chris83527/anna_elsa_schematics/anna_elsa_esp32_cpu/anna_elsa_esp32_cpu.png

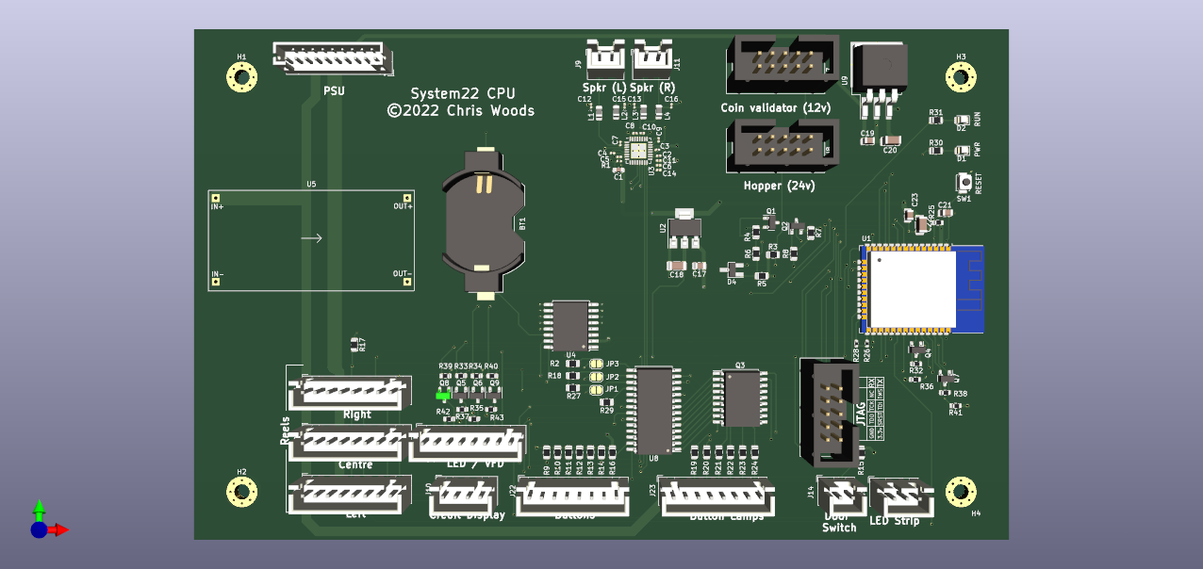
anna_elsa_esp32_cpu/anna_elsa_esp32_cpu.png
