chris83527/anna_elsa_schematics/README.md

# Schematics for Anna & Elsa fruit machine project
## based on ESP32 microcontroller
