chris83527/anna_elsa_schematics/anna_elsa_esp32_cpu/gerbers/board/anna_elsa_esp32_cpu-B_Cu.dxf

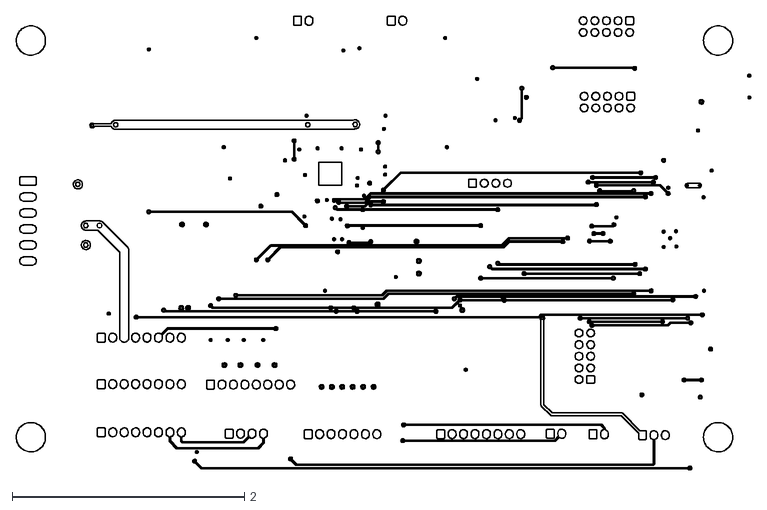
[picture p2: CAD file, 2023-01-22]
anna_elsa_esp32_cpu/gerbers/board/anna_elsa_esp32_cpu-B_Cu.dxf
6.32 x 3.90
