chris83527/anna_elsa_schematics/anna_elsa_esp32_cpu/gerbers/board/anna_elsa_esp32_cpu-F_Cu.dxf

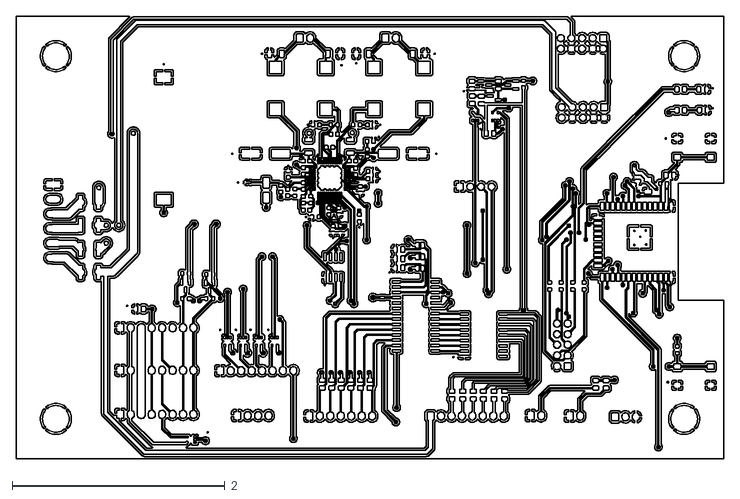
[picture p4: CAD file, 2023-01-22]
anna_elsa_esp32_cpu/gerbers/board/anna_elsa_esp32_cpu-F_Cu.dxf
6.66 x 4.16
