chris83527/anna_elsa_schematics/anna_elsa_esp32_cpu/gerbers/board/anna_elsa_esp32_cpu-Edge_Cuts.dxf

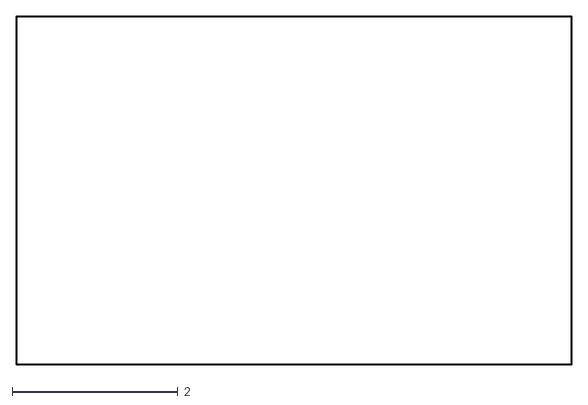
[picture p5: CAD file, 2023-01-22]
anna_elsa_esp32_cpu/gerbers/board/anna_elsa_esp32_cpu-Edge_Cuts.dxf
6.70 x 4.20
