chris83527/anna_elsa_schematics/anna_elsa_esp32_cpu/gerbers/board/anna_elsa_esp32_cpu-In2_Cu.dxf

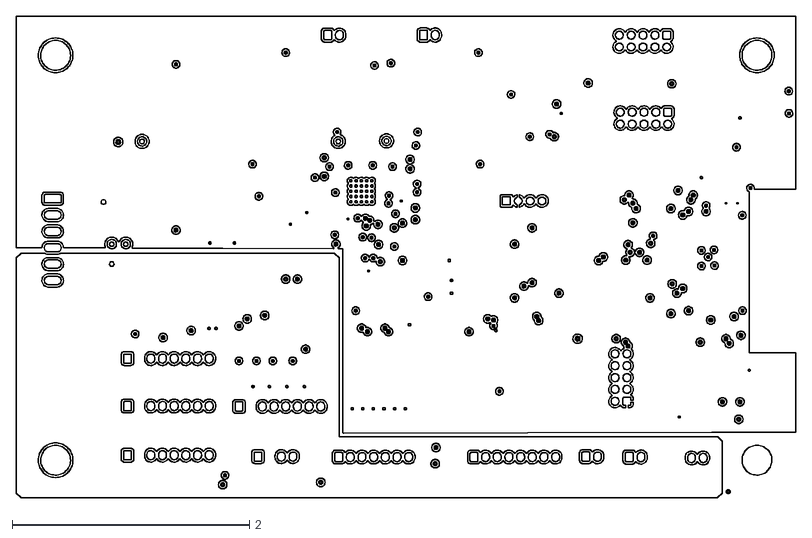
[picture p6: CAD file, 2023-01-22]
anna_elsa_esp32_cpu/gerbers/board/anna_elsa_esp32_cpu-In2_Cu.dxf
6.57 x 4.06
