chris83527/anna_elsa_schematics/(list of files, cad)

Other CAD files:
anna_elsa_esp32_cpu/gerbers/board/anna_elsa_esp32_cpu-F_Mask.dxf
anna_elsa_esp32_cpu/gerbers/board/anna_elsa_esp32_cpu-F_Paste.dxf
anna_elsa_esp32_cpu/gerbers/board/anna_elsa_esp32_cpu-F_Silkscreen.dxf
