chris83527/anna_elsa_schematics/anna_elsa_esp32_cpu/Board2Pdf/anna_elsa_esp32_cpu-Assembly.pdf

1 | 2 | 3 | 4 | 5 | 6

A

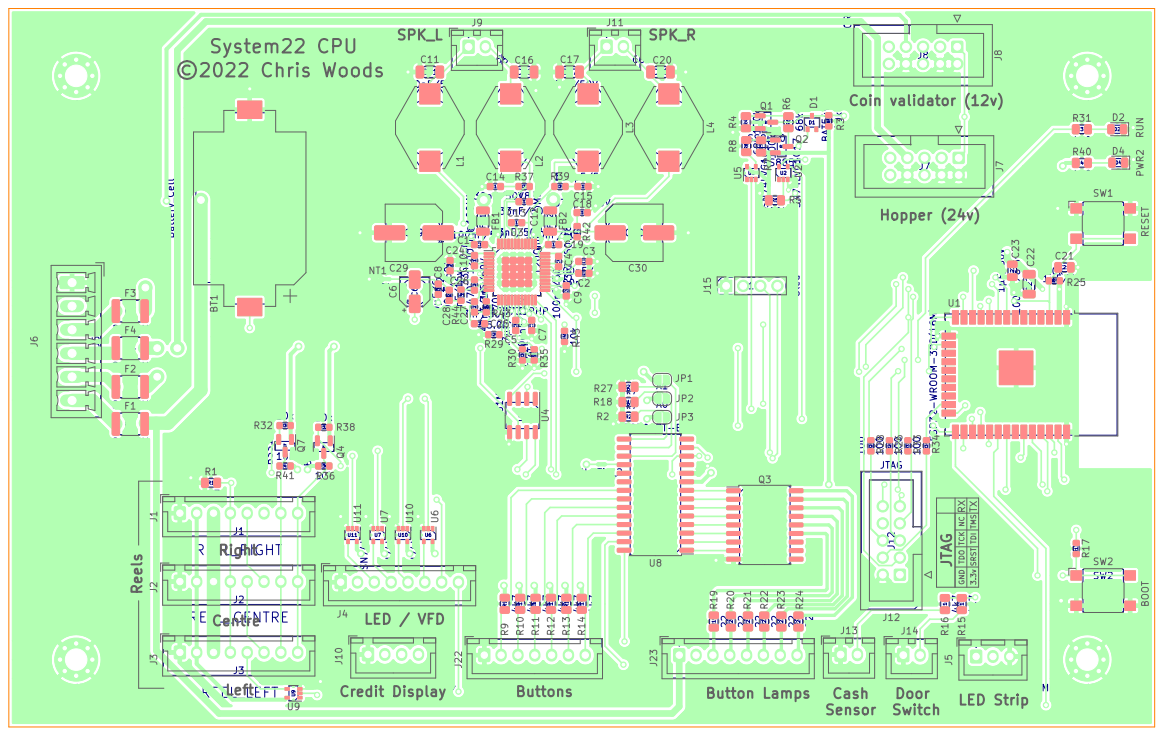
[picture p7: page 1]

Id: 1/1 Title: File: anna_elsa_esp32_cpu.kicad_pcb Sheet: ColoredTop

1 | 2 | 3 | 4 | 5 | 6

A

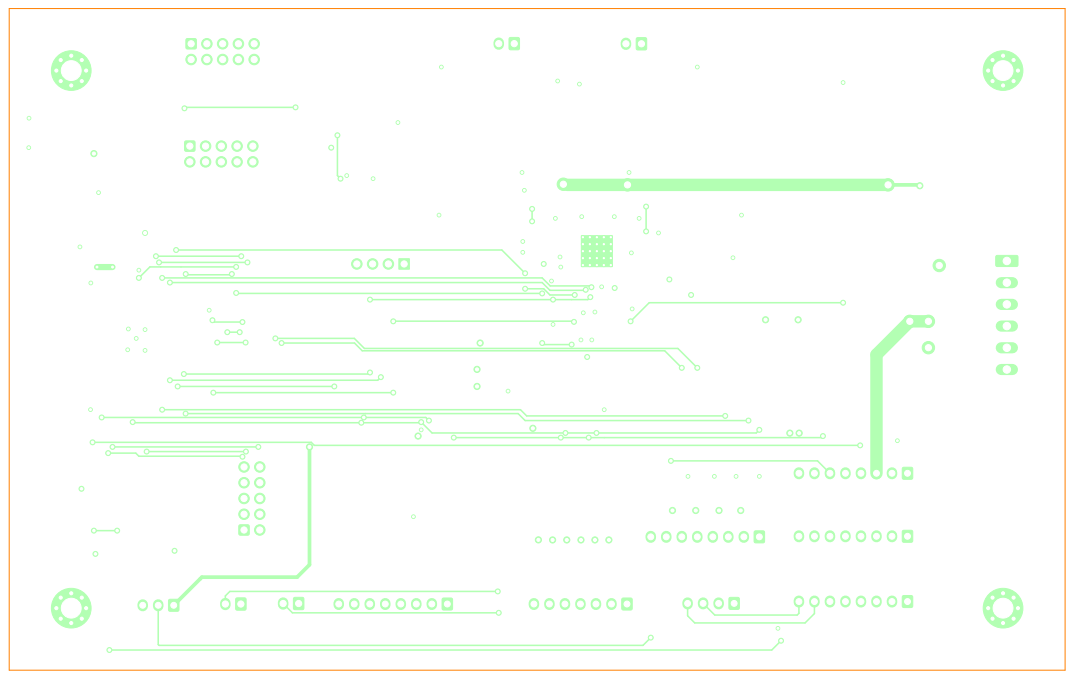
[picture p8: page 2]
D Date: KiCad; kicad; 6.0.11-2627ca5db0~126~ubuntu20.04.1 Size: A4; Rev:

Id: 1/1 Title: File: anna_elsa_esp32_cpu.kicad_pcb Sheet: ColoredBottom
