chris83527/anna_elsa_schematics/anna_elsa_esp32_cpu/anna_elsa_esp32_cpu.pdf

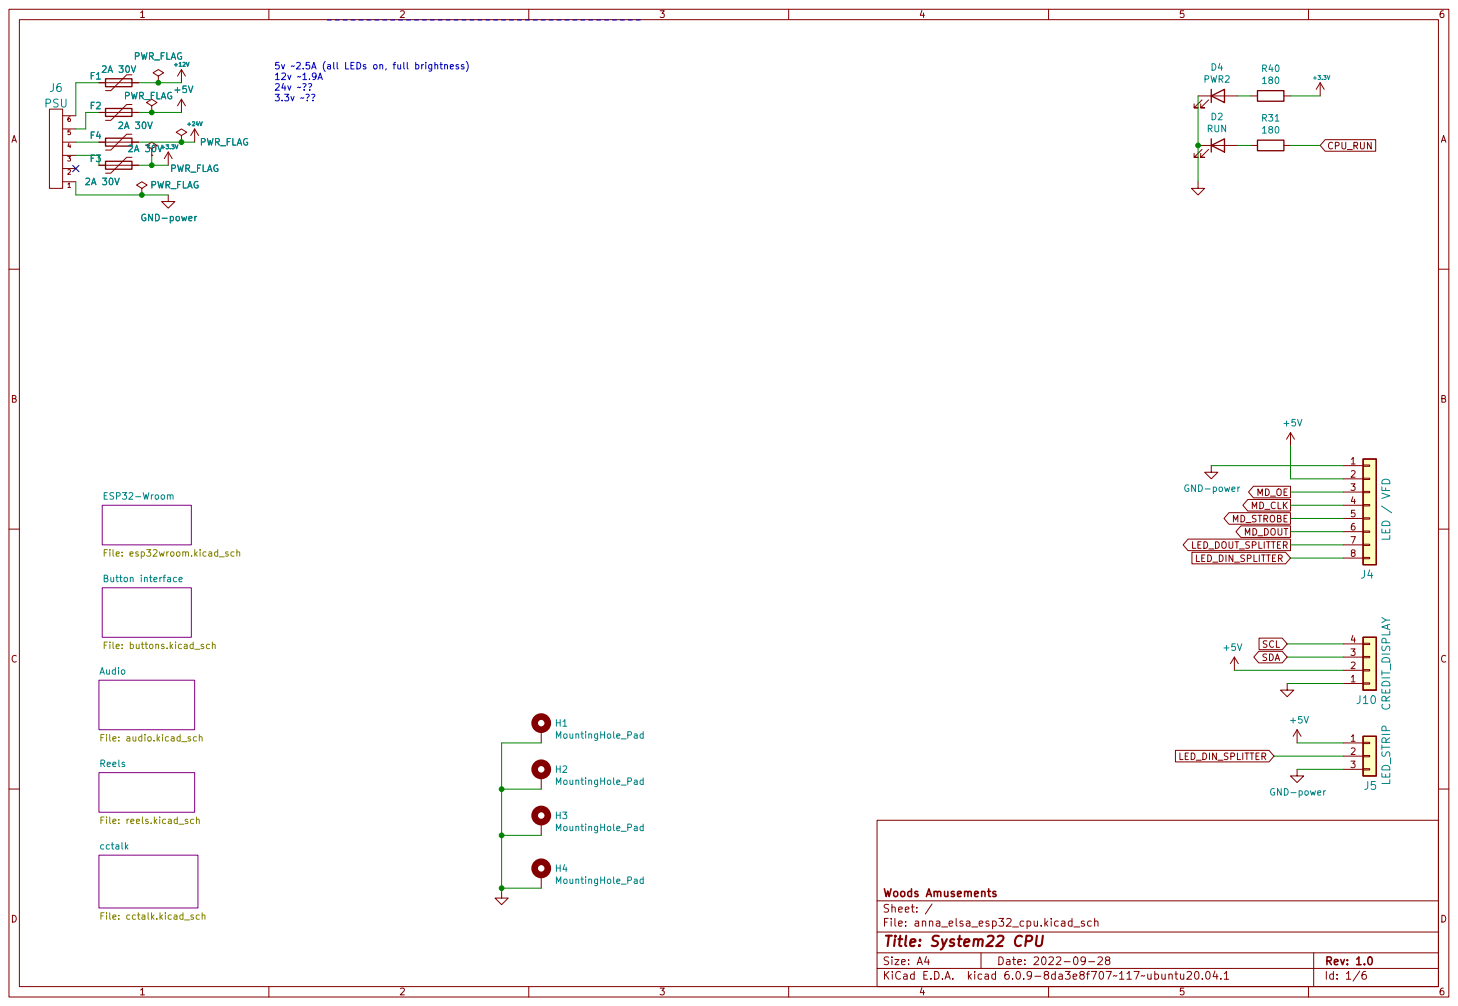
[picture p9: page 1]

5v ~2.5A (all LEDs on, full brightness) 12v ~1.9A

cctalk File: cctalk.kicad_sch ESP32-Wroom

File: esp32wroom.kicad_sch Audio File: audio.kicad_sch Button interface File: buttons.kicad_sch

File: anna_elsa_esp32_cpu.kicad_sch Sheet: / Woods Amusements Reels File: reels.kicad_sch

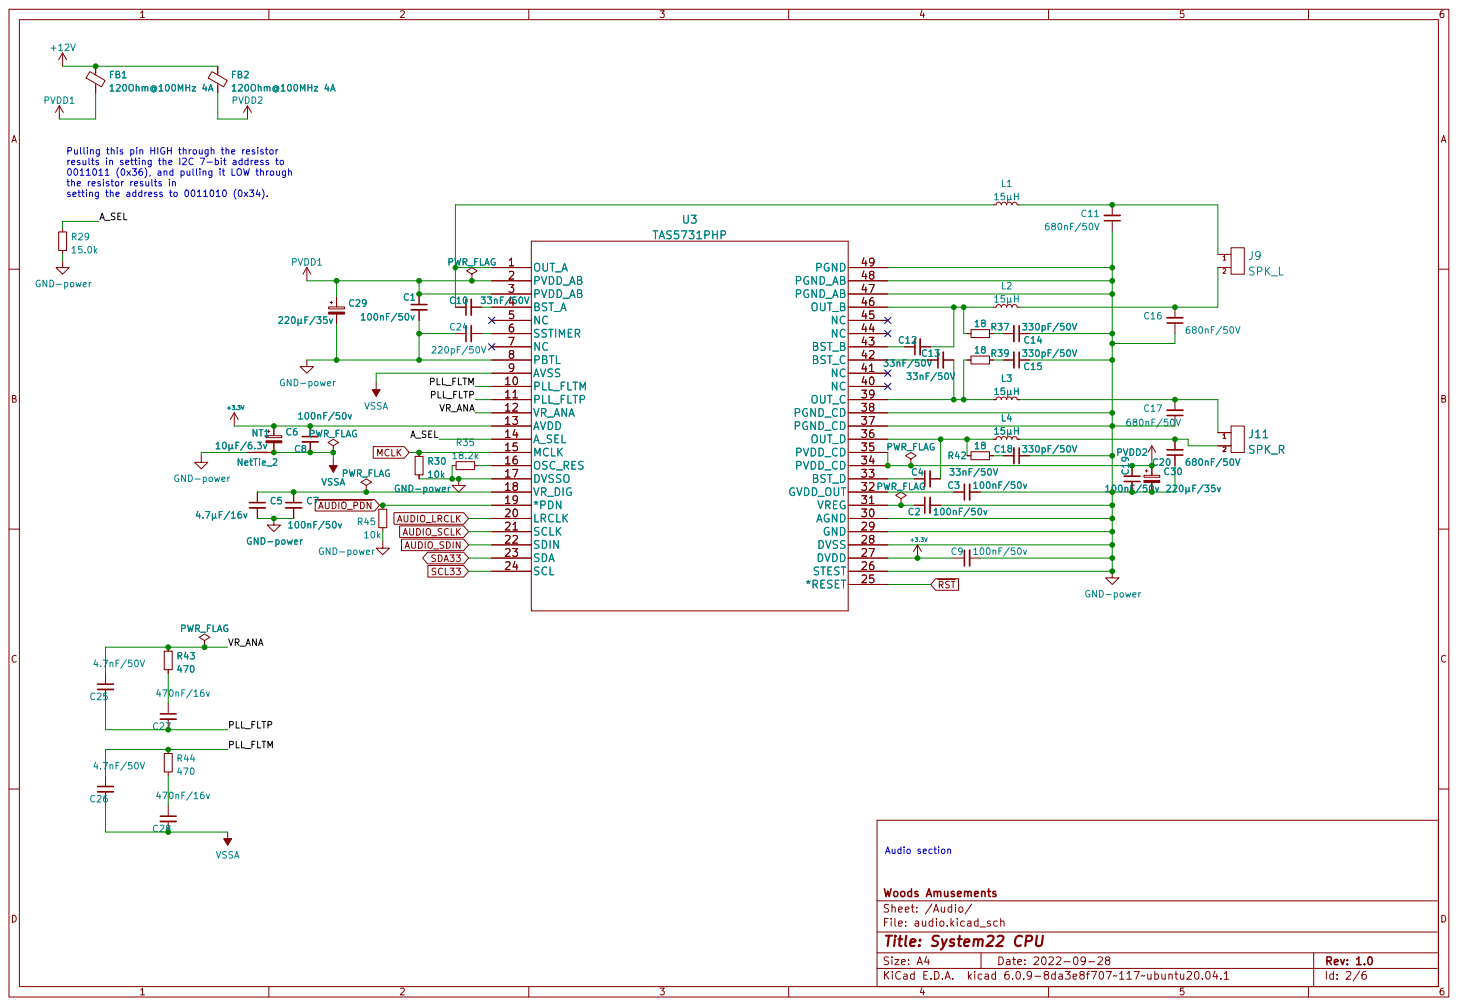
[picture p10: page 2]

Pulling this pin HIGH through the resistor
results in setting the I2C 7-bit address to
0011011 (0x36), and pulling it LOW through
the resistor results in
setting the address to 0011010 (0x34).

File: audio.kicad_sch Sheet: /Audio/ Woods Amusements R45

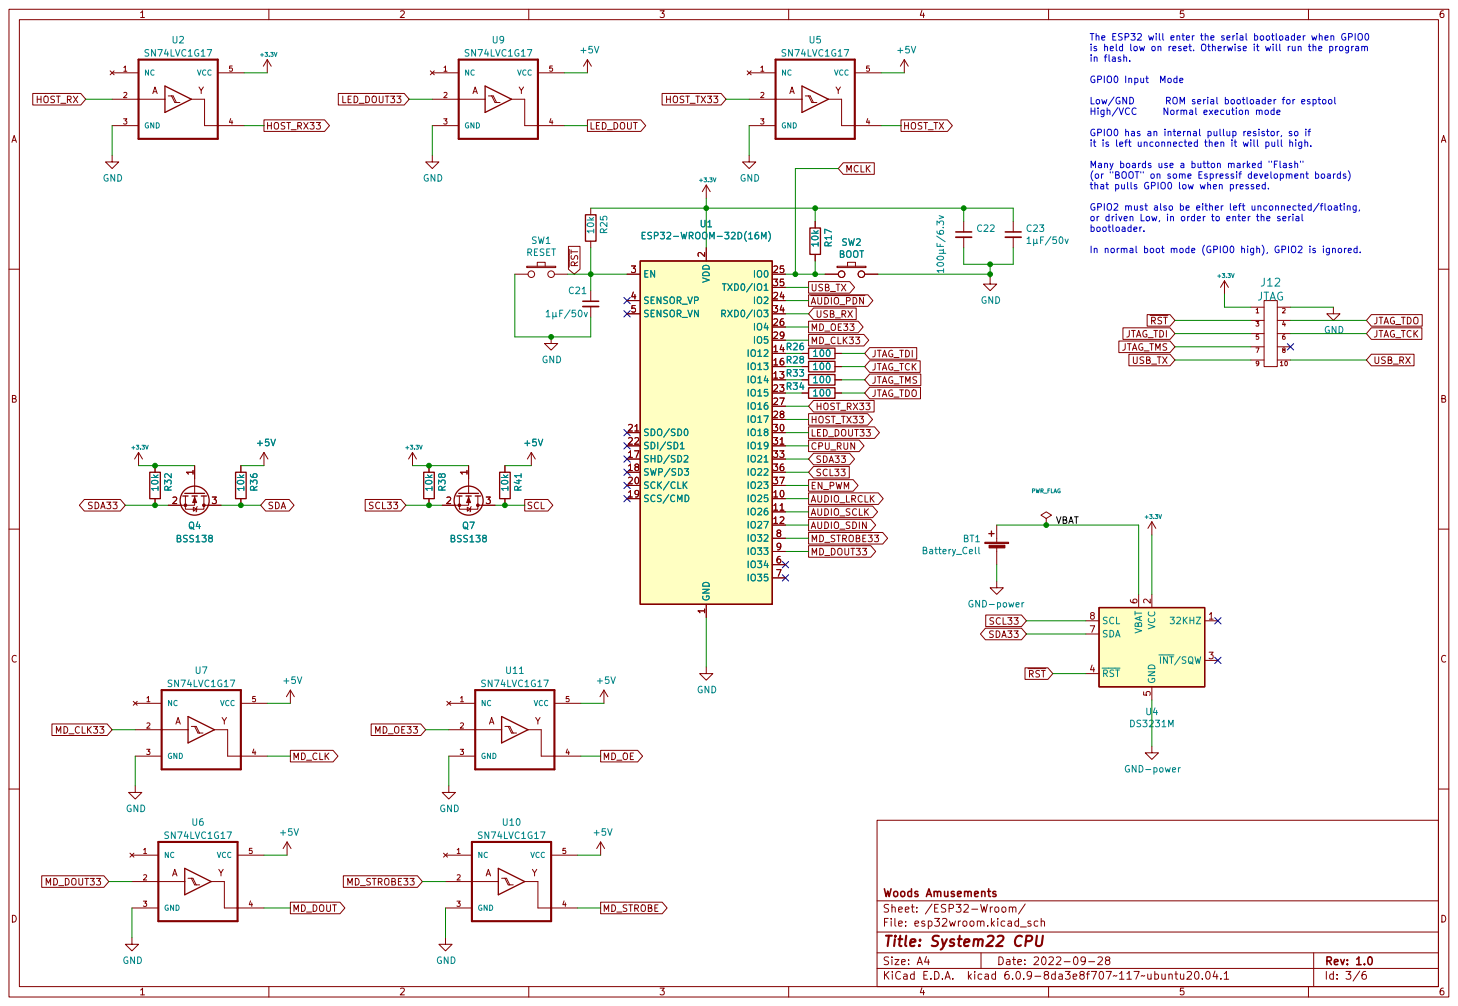
[picture p11: page 3]

The ESP32 will enter the serial bootloader when GPIO0
is held low on reset. Otherwise it will run the program
in flash. GPIO0 Input Mode

High/VCC Normal execution mode

GPIO0 has an internal pullup resistor, so if
it is left unconnected then it will pull high.

Many boards use a button marked "Flash"
(or "BOOT" on some Espressif development boards)
that pulls GPIO0 low when pressed.

GPIO2 must also be either left unconnected/floating, or driven Low, in order to enter the serial bootloader.

2 SCK/CLK 20 SDO/SD0 21 SDI/SD1 22

2 ~{INT}/SQW 3 ~{RST} 4 GND

File: esp32wroom.kicad_sch Sheet: /ESP32-Wroom/ Woods Amusements GND

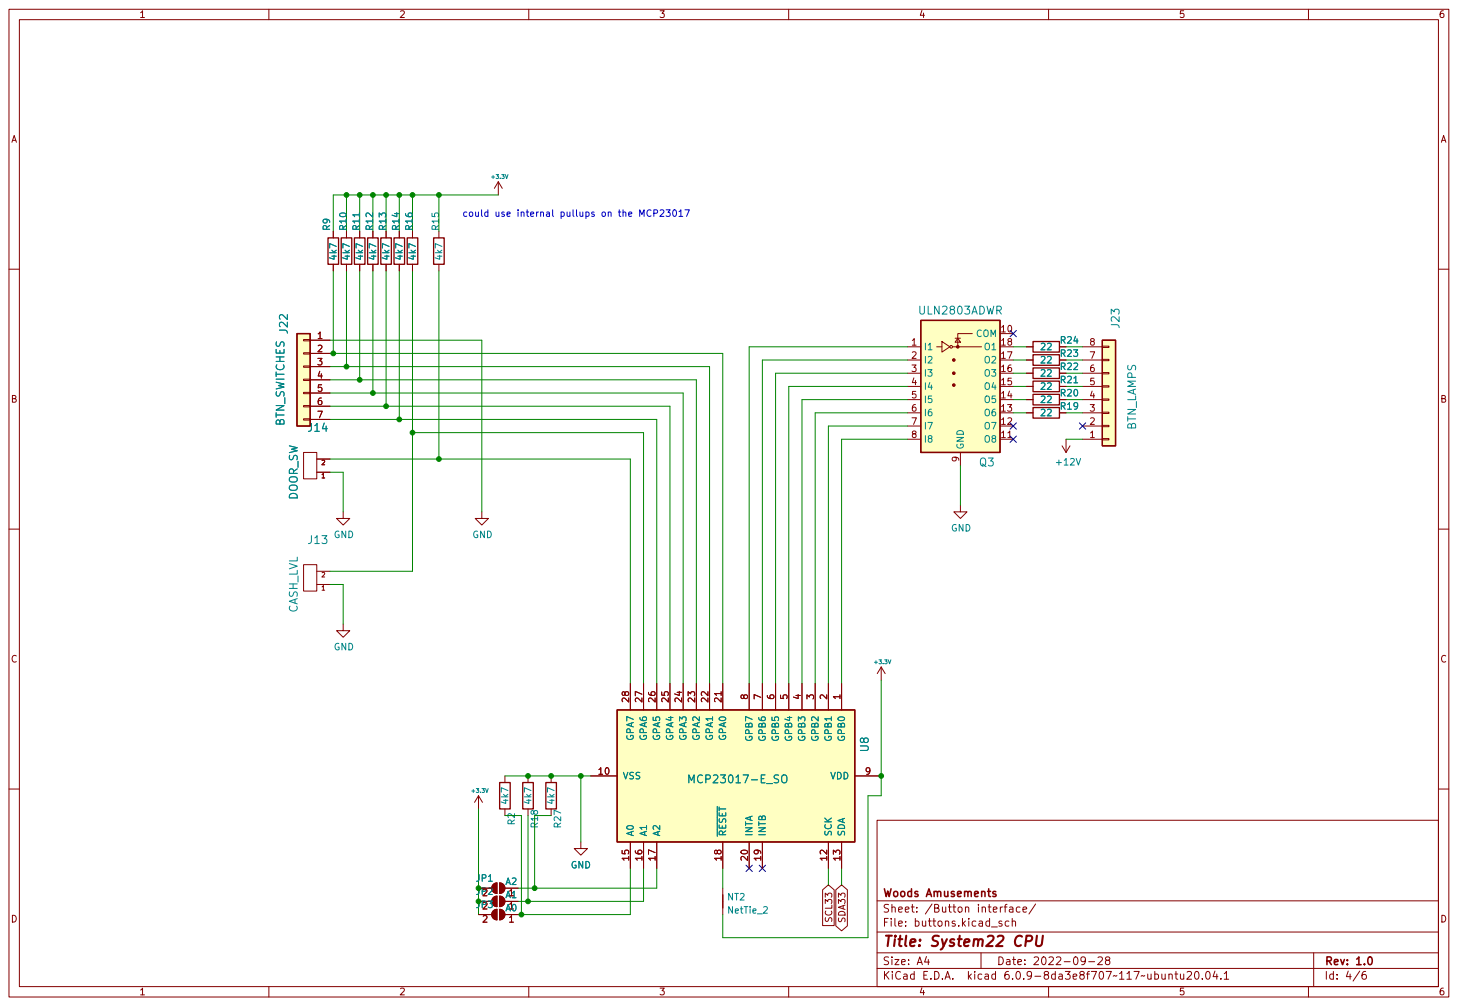
[picture p12: page 4]

could use internal pullups on the MCP23017

1 VSS 10 SCK 12 SDA 13 A0 15 A1 16 A2 17 ~{RESET} 18 INTB 19 GPB1

MCP23017-E_SO | GPB0

JP2 JP2 2 2 | A1 A1 1 1
JP3 JP32 2 | A0 A01 1

NT2 NetTie_2

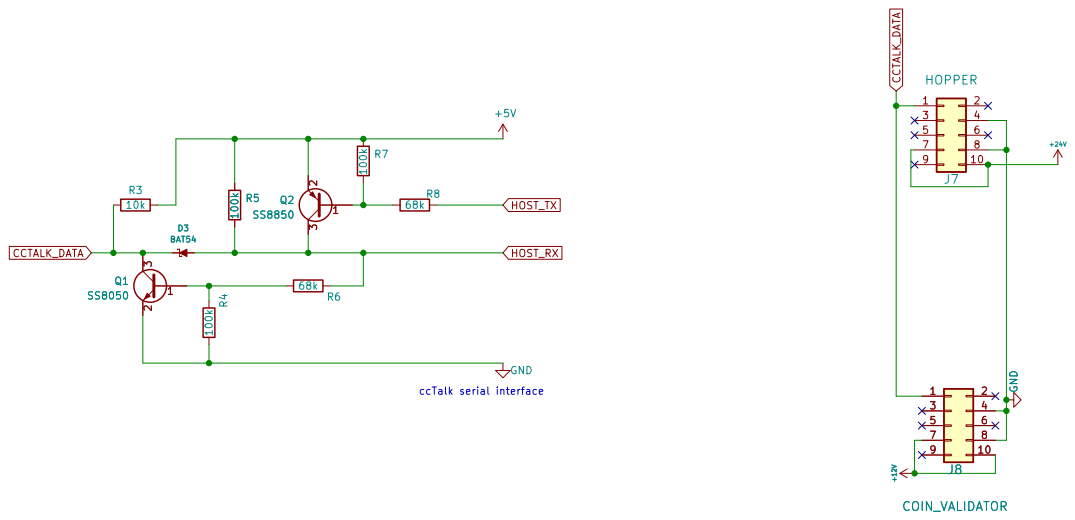
[picture p13: page 5]

File: cctalk.kicad_sch Sheet: /cctalk/ Woods Amusements GND

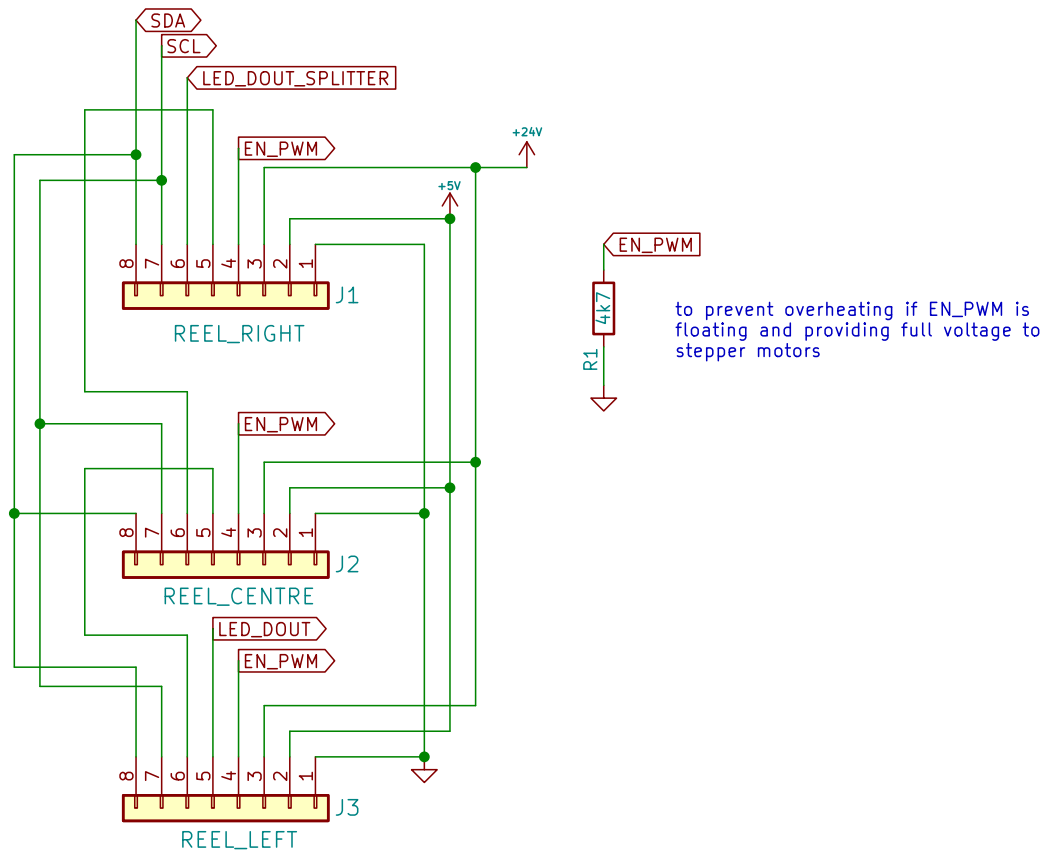
[picture p14: page 6]

to prevent overheating if EN_PWM is
floating and providing full voltage to stepper motors

File: reels.kicad_sch Sheet: /Reels/ Woods Amusements
