chris83527/anna_elsa_schematics/message_display_interface/message_display_interface.kicad_pcb

## KiCad design message_display_interface/message_display_interface.kicad_pcb (2023-09-29)

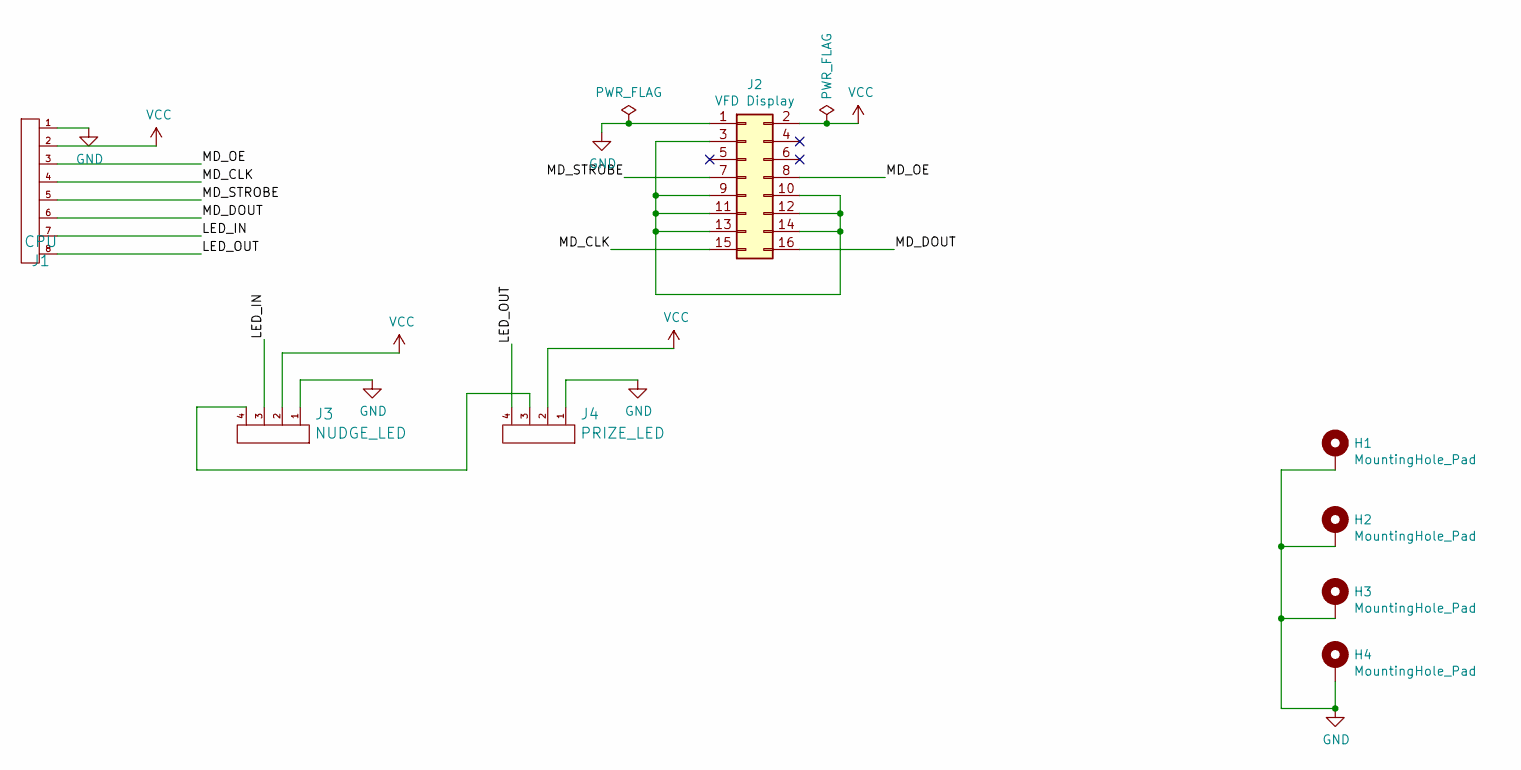
[picture p15: schematic message_display_interface.sch]

Parts:
H1, H2, H3, H4: MountingHole_Pad; MountingHole_3.2mm_M3_Pad
J1: CPU; JST_XH_B8B-XH-A_1x08_P2.50mm_Vertical
J2: VFD Display; IDC-Header_2x08_P2.54mm_Vertical
J3: NUDGE_LED; JST_XH_B4B-XH-A_1x04_P2.50mm_Vertical
J4: PRIZE_LED; JST_XH_B4B-XH-A_1x04_P2.50mm_Vertical

Connections:
/LED_IN: J1.7, J3.3
/LED_OUT: J1.8, J4.4
/MD_CLK: J1.4, J2.15
/MD_DOUT: J1.6, J2.16
/MD_OE: J1.3, J2.8
/MD_STROBE: J1.5, J2.7
GND: H1.1, H2.1, H3.1, H4.1, J1.1, J2.1, J3.1, J4.1
unnamed: J2.3, J2.9, J2.10, J2.11, J2.12, J2.13, J2.14
unnamed: J3.4, J4.3
VCC: J1.2, J2.2, J3.2, J4.2

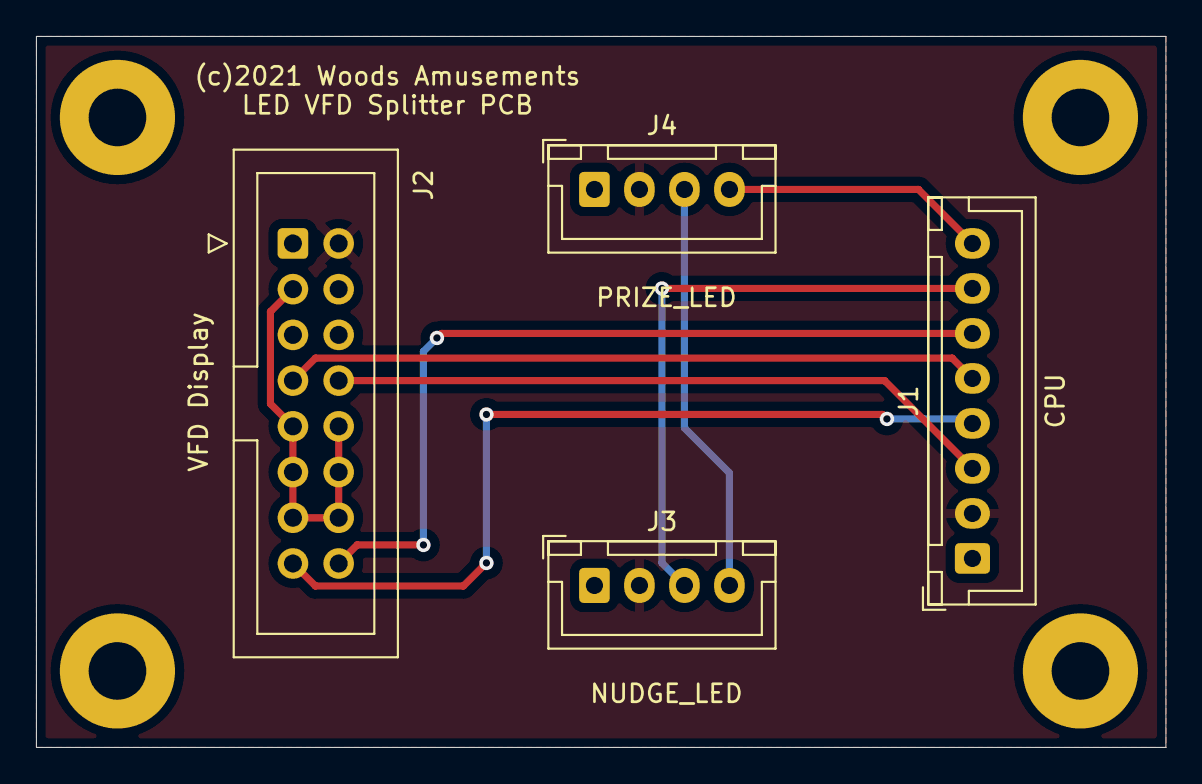
[picture p16: board message_display_interface.kicad_pcb from above]

Board: 2 copper layers, 62.8 x 39.5 mm, 8 parts (0 on the bottom side), 10 nets.
