chris83527/anna_elsa_schematics/anna_elsa_moves_display/anna_elsa_moves_display.kicad_pcb

## KiCad design anna_elsa_moves_display/anna_elsa_moves_display.kicad_pcb (2023-09-29)

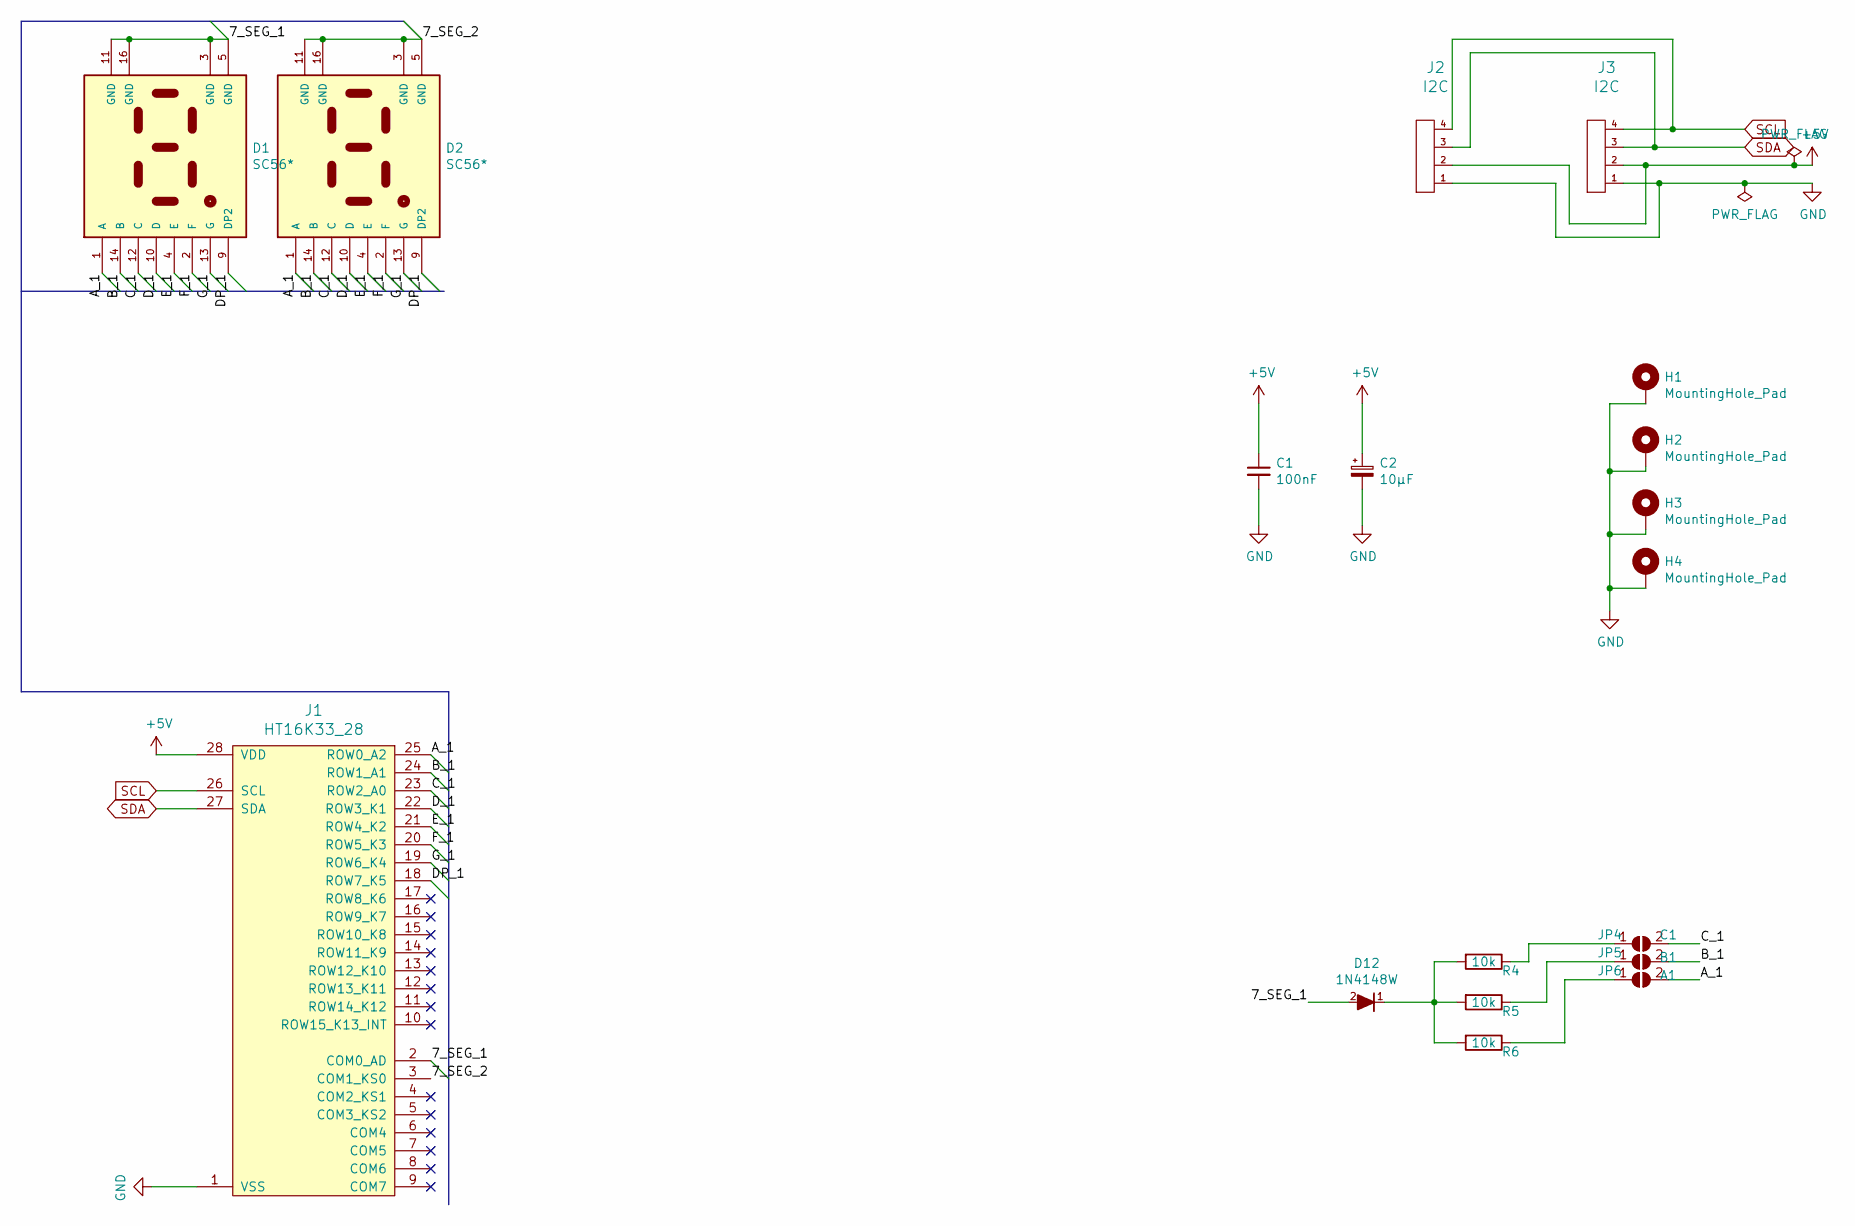
[picture p17: schematic anna_elsa_moves_display.sch, Anna and Elsa Moves Display PCB]

Parts:
C1: 100nF; C_Disc_D4.3mm_W1.9mm_P5.00mm; LCSC C14663
C2: 10µF; CP_Radial_D6.3mm_P2.50mm; LCSC C96123
D1, D2: SC56*; DIP14_KINGBRIGHT_SX08
D12: 1N4148W; D_A-405_P7.62mm_Horizontal; LCSC C81598
H1, H2, H3, H4: MountingHole_Pad; MountingHole_3.2mm_M3_Pad
J1: HT16K33_28; SOP-28_7.5x15.4mm_P1.27mm
J2, J3: I2C; JST_XH_B4B-XH-A_1x04_P2.50mm_Vertical
JP4: C1; SolderJumper-2_P1.3mm_Open_Pad1.0x1.5mm
JP5: B1; SolderJumper-2_P1.3mm_Open_Pad1.0x1.5mm
JP6: A1; SolderJumper-2_P1.3mm_Open_Pad1.0x1.5mm
R4, R6: 10k; R_Axial_DIN0207_L6.3mm_D2.5mm_P7.62mm_Horizontal; LCSC C25804
R5: 10k; R_Axial_DIN0207_L6.3mm_D2.5mm_P7.62mm_Horizontal

Connections:
+5V: C1.1, C2.1, J1.28 (VDD), J2.2, J3.2
/7_SEG_1: D1.3 (GND), D1.5 (GND), D1.11 (GND), D1.16 (GND), D12.2 (A), J1.2 (COM0_AD)
/7_SEG_2: D2.3 (GND), D2.5 (GND), D2.11 (GND), D2.16 (GND), J1.3 (COM1_KS0)
/A_1: D1.1 (A), D2.1 (A), J1.25 (ROW0_A2), JP6.2 (B)
/B_1: D1.14 (B), D2.14 (B), J1.24 (ROW1_A1), JP5.2 (B)
/C_1: D1.12 (C), D2.12 (C), J1.23 (ROW2_A0), JP4.2 (B)
/DP_1: D1.9 (DP2), D2.9 (DP2), J1.18 (ROW7_K5)
/D_1: D1.10 (D), D2.10 (D), J1.22 (ROW3_K1)
/E_1: D1.4 (E), D2.4 (E), J1.21 (ROW4_K2)
/F_1: D1.2 (F), D2.2 (F), J1.20 (ROW5_K3)
/G_1: D1.13 (G), D2.13 (G), J1.19 (ROW6_K4)
GND: C1.2, C2.2, H1.1, H2.1, H3.1, H4.1, J1.1 (VSS), J2.1, J3.1
unnamed: D12.1 (K), R4.2, R5.2, R6.2
unnamed: JP4.1 (A), R4.1
unnamed: JP5.1 (A), R5.1
unnamed: JP6.1 (A), R6.1
SCL: J1.26 (SCL), J2.4, J3.4
SDA: J1.27 (SDA), J2.3, J3.3

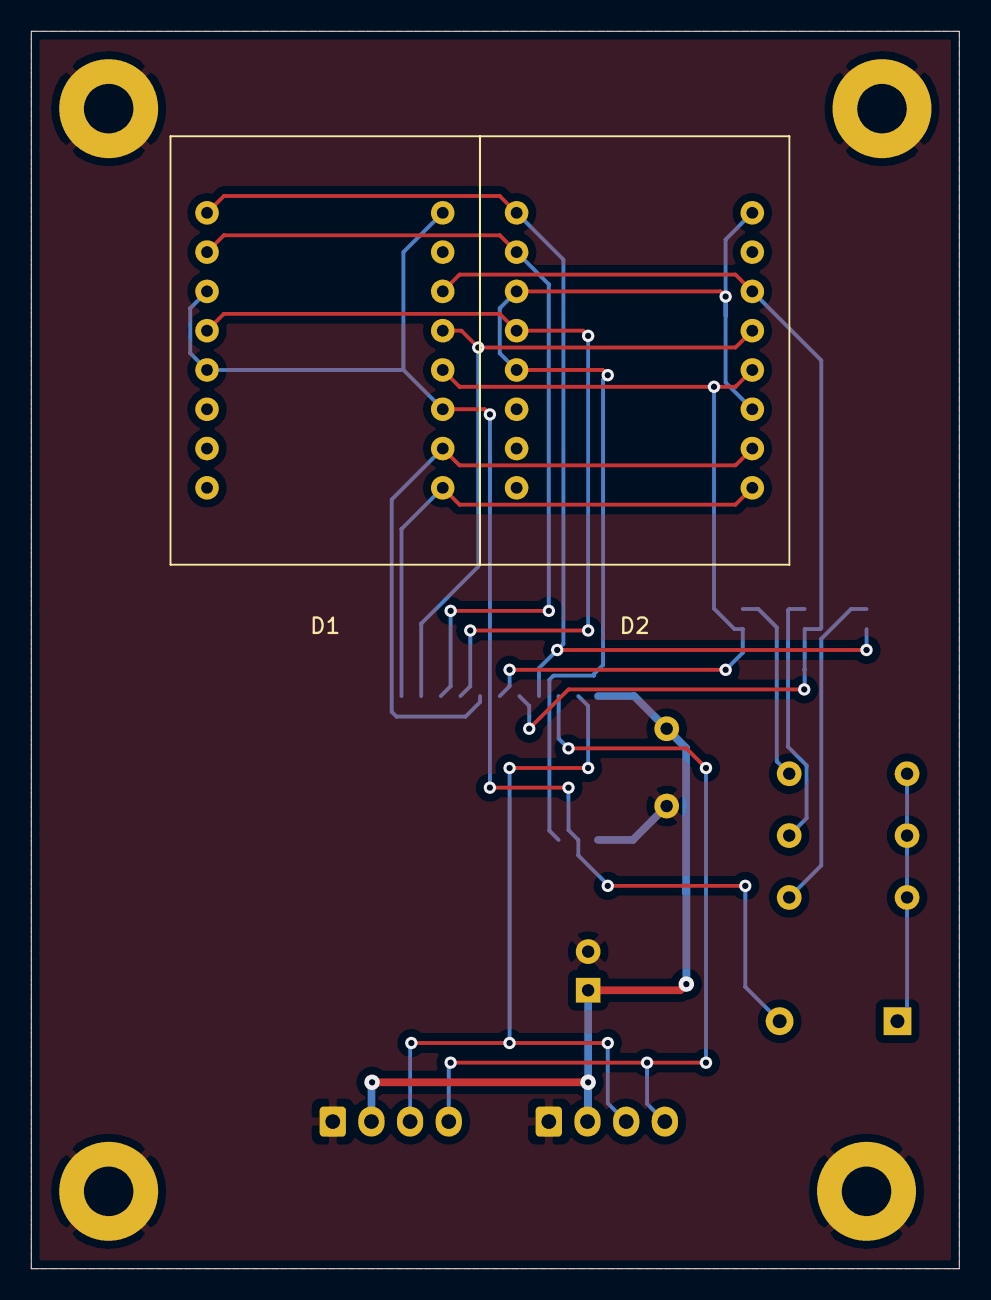
[picture p18: board anna_elsa_moves_display.kicad_pcb from above]

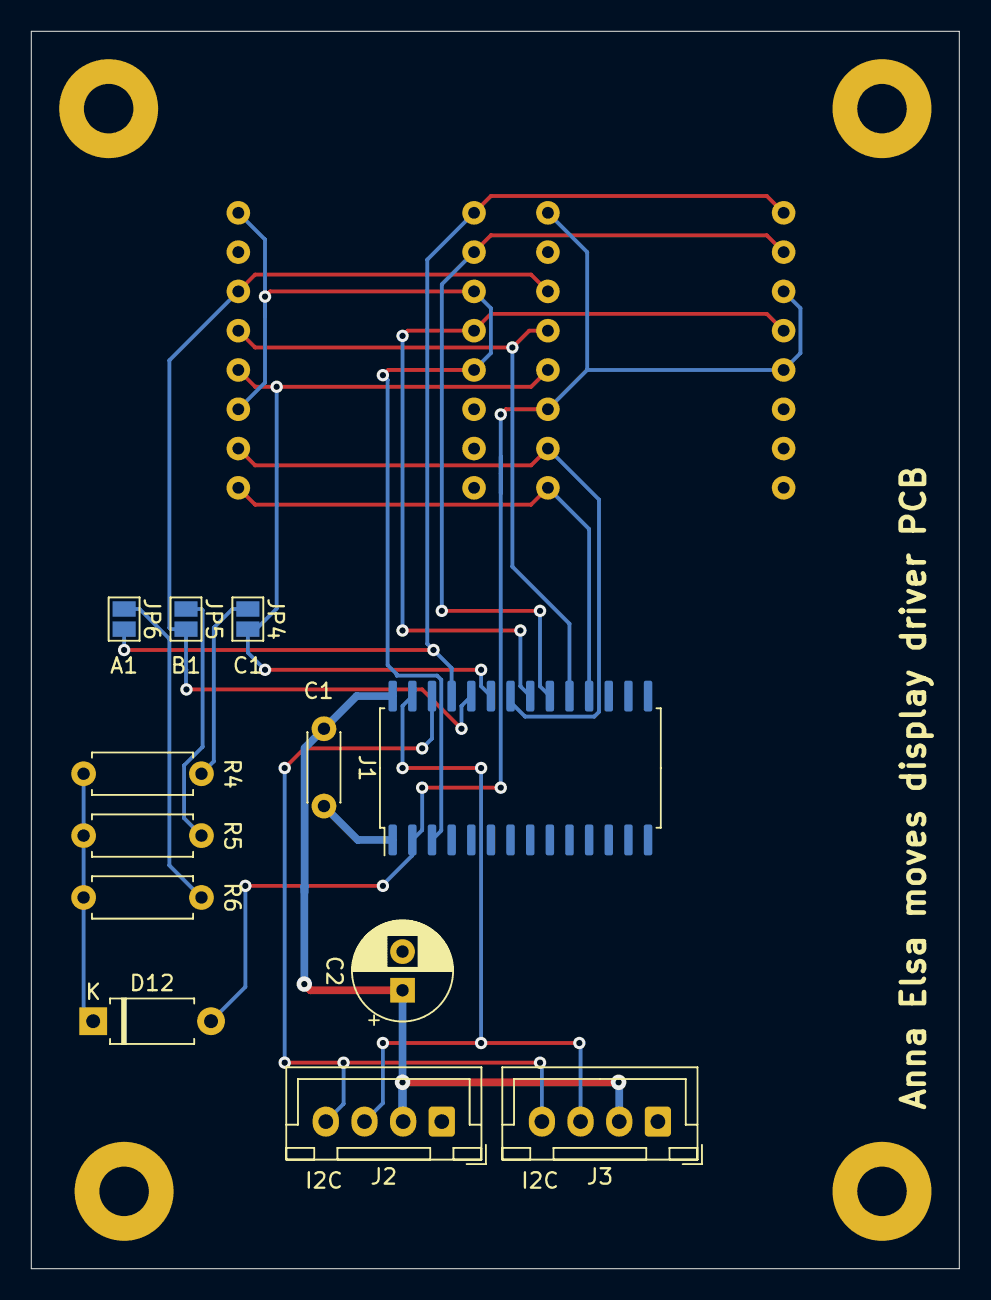
[picture p19: board anna_elsa_moves_display.kicad_pcb from below]

Board: 2 copper layers, 60.0 x 80.0 mm, 18 parts (12 on the bottom side), 18 nets.
