chris83527/anna_elsa_schematics/anna_elsa_credit_display/anna_elsa_credit_display.kicad_pcb

## KiCad design anna_elsa_credit_display/anna_elsa_credit_display.kicad_pcb (2023-09-29)

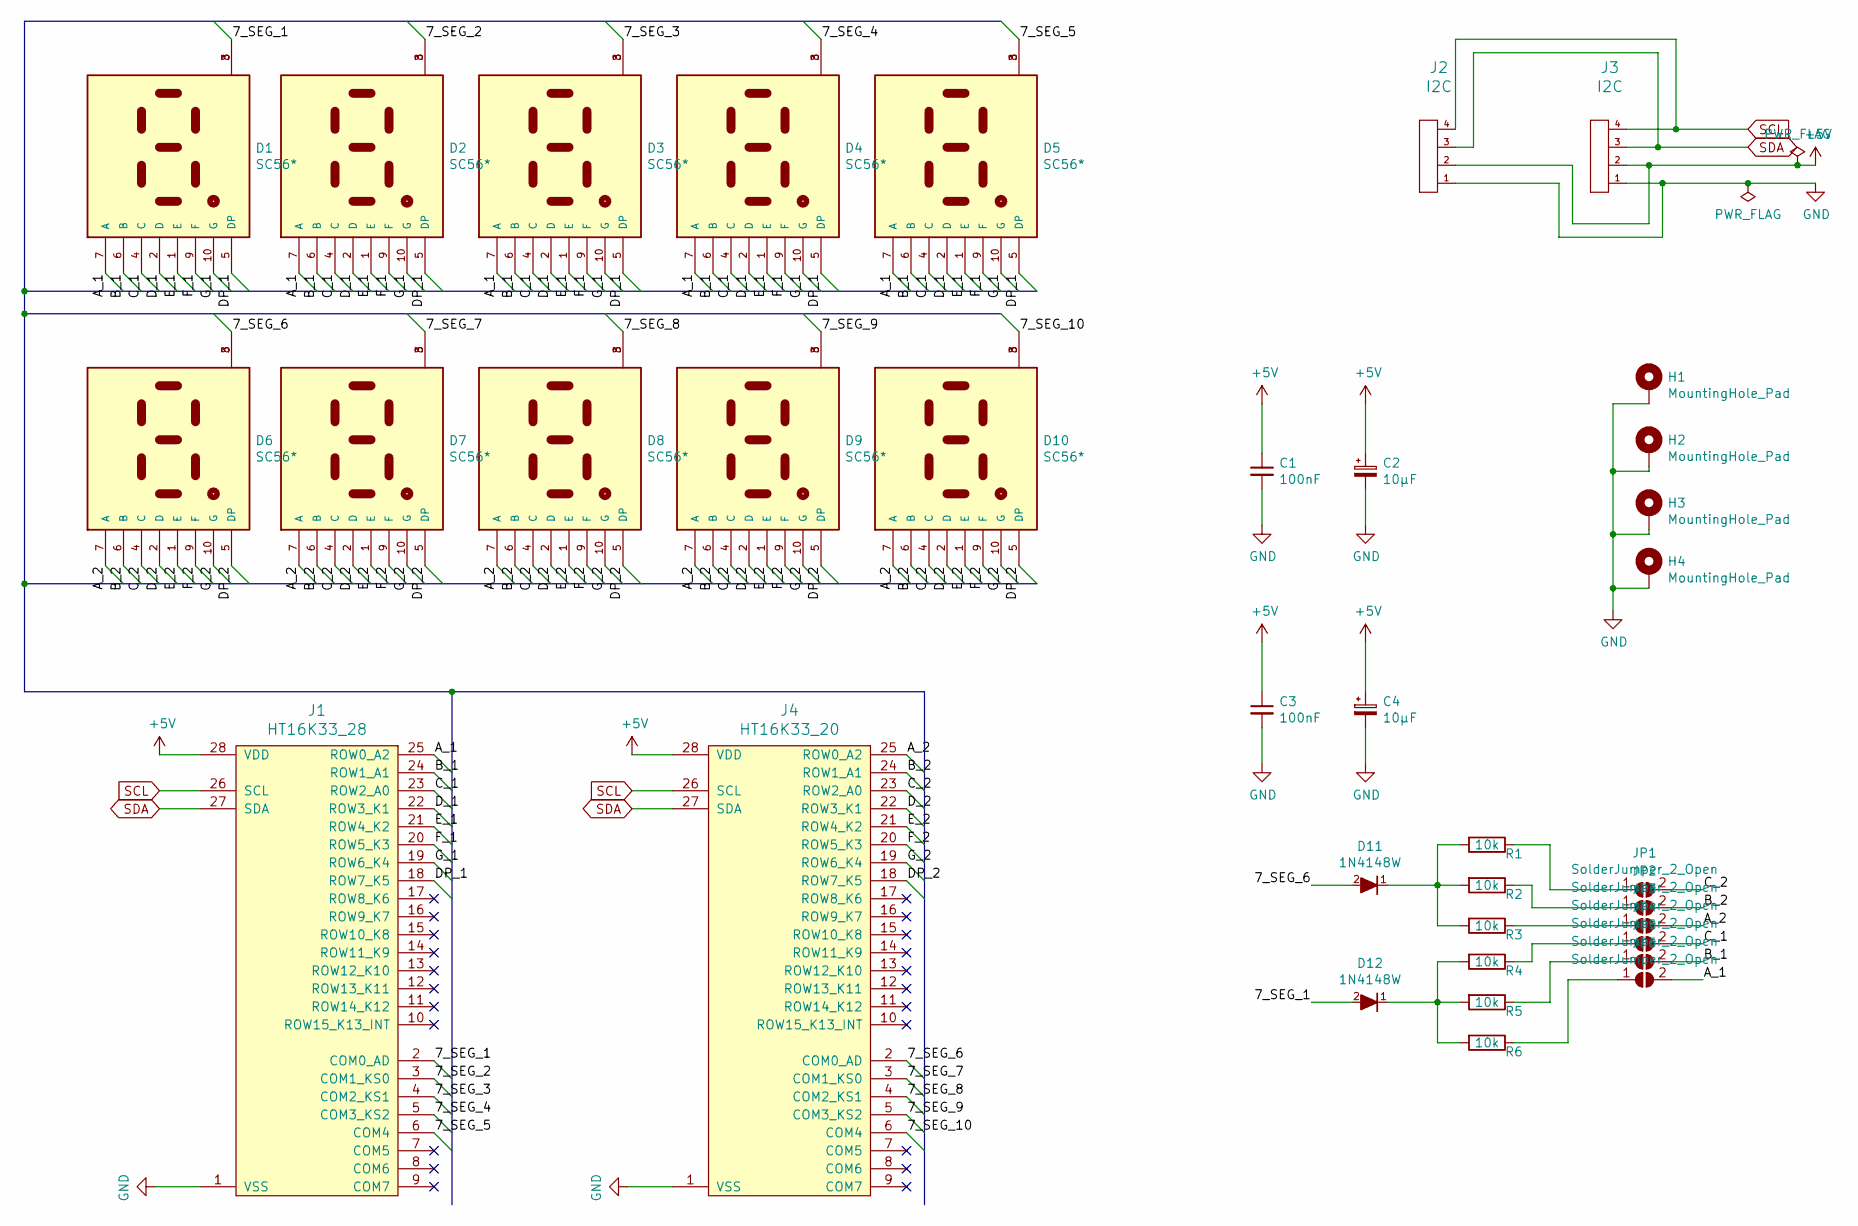
[picture p20: schematic anna_elsa_credit_display.sch, Anna and Elsa Credit Display PCB]

Parts:
C1, C3: 100nF; C_Disc_D4.3mm_W1.9mm_P5.00mm; LCSC C14663
C2, C4: 10µF; CP_Radial_D6.3mm_P2.50mm; LCSC C96123
D1, D2, D3, D4, D5, D6, D7, D8, D9, D10: SC56*; DIP10_KINGBRIGHT_SX56
D11, D12: 1N4148W; D_A-405_P7.62mm_Horizontal; LCSC C81598
H1, H2, H3, H4: MountingHole_Pad; MountingHole_3.2mm_M3_Pad
J1: HT16K33_28; SOP-28_7.5x15.4mm_P1.27mm
J2, J3: I2C; JST_XH_B4B-XH-A_1x04_P2.50mm_Vertical
J4: HT16K33_20; SOP-28_7.5x15.4mm_P1.27mm
JP1, JP2, JP3, JP4, JP5, JP6: SolderJumper_2_Open; SolderJumper-2_P1.3mm_Open_Pad1.0x1.5mm
R1, R2, R4, R6: 10k; R_Axial_DIN0207_L6.3mm_D2.5mm_P7.62mm_Horizontal; LCSC C25804
R3, R5: 10k; R_Axial_DIN0207_L6.3mm_D2.5mm_P7.62mm_Horizontal

Connections:
+5V: C1.1, C2.1, C3.1, C4.1, J1.28 (VDD), J2.2, J3.2, J4.28 (VDD)
/7_SEG_1: D1.3, D1.8, D12.2 (A), J1.2 (COM0_AD)
/7_SEG_2: D2.3, D2.8, J1.3 (COM1_KS0)
/7_SEG_3: D3.3, D3.8, J1.4 (COM2_KS1)
/7_SEG_4: D4.3, D4.8, J1.5 (COM3_KS2)
/7_SEG_5: D5.3, D5.8, J1.6 (COM4)
/7_SEG_6: D6.3, D6.8, D11.2 (A), J4.2 (COM0_AD)
/7_SEG_7: D7.3, D7.8, J4.3 (COM1_KS0)
/7_SEG_8: D8.3, D8.8, J4.4 (COM2_KS1)
/7_SEG_9: D9.3, D9.8, J4.5 (COM3_KS2)
/7_SEG_10: D10.3, D10.8, J4.6 (COM4)
/A_1: D1.7 (A), D2.7 (A), D3.7 (A), D4.7 (A), D5.7 (A), J1.25 (ROW0_A2), JP6.2 (B)
/A_2: D6.7 (A), D7.7 (A), D8.7 (A), D9.7 (A), D10.7 (A), J4.25 (ROW0_A2), JP3.2 (B)
/B_1: D1.6 (B), D2.6 (B), D3.6 (B), D4.6 (B), D5.6 (B), J1.24 (ROW1_A1), JP5.2 (B)
/B_2: D6.6 (B), D7.6 (B), D8.6 (B), D9.6 (B), D10.6 (B), J4.24 (ROW1_A1), JP2.2 (B)
/C_1: D1.4 (C), D2.4 (C), D3.4 (C), D4.4 (C), D5.4 (C), J1.23 (ROW2_A0), JP4.2 (B)
/C_2: D6.4 (C), D7.4 (C), D8.4 (C), D9.4 (C), D10.4 (C), J4.23 (ROW2_A0), JP1.2 (B)
/DP_1: D1.5 (DP), D2.5 (DP), D3.5 (DP), D4.5 (DP), D5.5 (DP), J1.18 (ROW7_K5)
/DP_2: D6.5 (DP), D7.5 (DP), D8.5 (DP), D9.5 (DP), D10.5 (DP), J4.18 (ROW7_K5)
/D_1: D1.2 (D), D2.2 (D), D3.2 (D), D4.2 (D), D5.2 (D), J1.22 (ROW3_K1)
/D_2: D6.2 (D), D7.2 (D), D8.2 (D), D9.2 (D), D10.2 (D), J4.22 (ROW3_K1)
/E_1: D1.1 (E), D2.1 (E), D3.1 (E), D4.1 (E), D5.1 (E), J1.21 (ROW4_K2)
/E_2: D6.1 (E), D7.1 (E), D8.1 (E), D9.1 (E), D10.1 (E), J4.21 (ROW4_K2)
/F_1: D1.9 (F), D2.9 (F), D3.9 (F), D4.9 (F), D5.9 (F), J1.20 (ROW5_K3)
/F_2: D6.9 (F), D7.9 (F), D8.9 (F), D9.9 (F), D10.9 (F), J4.20 (ROW5_K3)
/G_1: D1.10 (G), D2.10 (G), D3.10 (G), D4.10 (G), D5.10 (G), J1.19 (ROW6_K4)
/G_2: D6.10 (G), D7.10 (G), D8.10 (G), D9.10 (G), D10.10 (G), J4.19 (ROW6_K4)
GND: C1.2, C2.2, C3.2, C4.2, H1.1, H2.1, H3.1, H4.1, J1.1 (VSS), J2.1, J3.1, J4.1 (VSS)
unnamed: D11.1 (K), R1.2, R2.2, R3.2
unnamed: D12.1 (K), R4.2, R5.2, R6.2
unnamed: JP1.1 (A), R1.1
unnamed: JP2.1 (A), R2.1
unnamed: JP3.1 (A), R3.1
unnamed: JP4.1 (A), R4.1
unnamed: JP5.1 (A), R5.1
unnamed: JP6.1 (A), R6.1
SCL: J1.26 (SCL), J2.4, J3.4, J4.26 (SCL)
SDA: J1.27 (SDA), J2.3, J3.3, J4.27 (SDA)

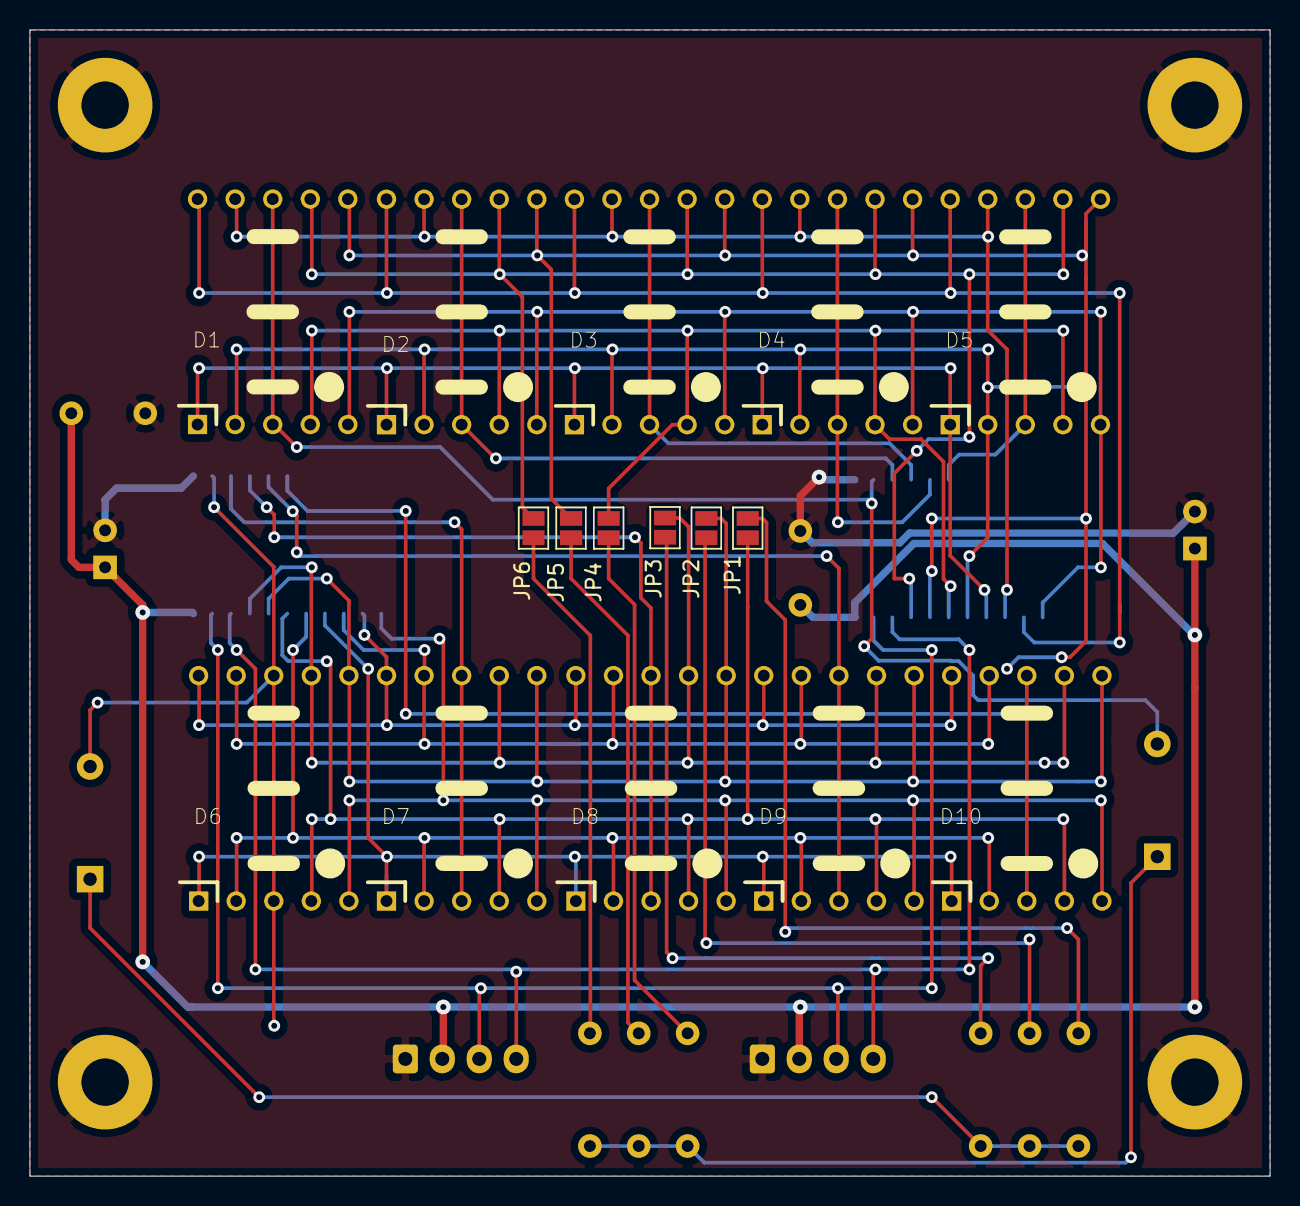
[picture p21: board anna_elsa_credit_display.kicad_pcb from above]

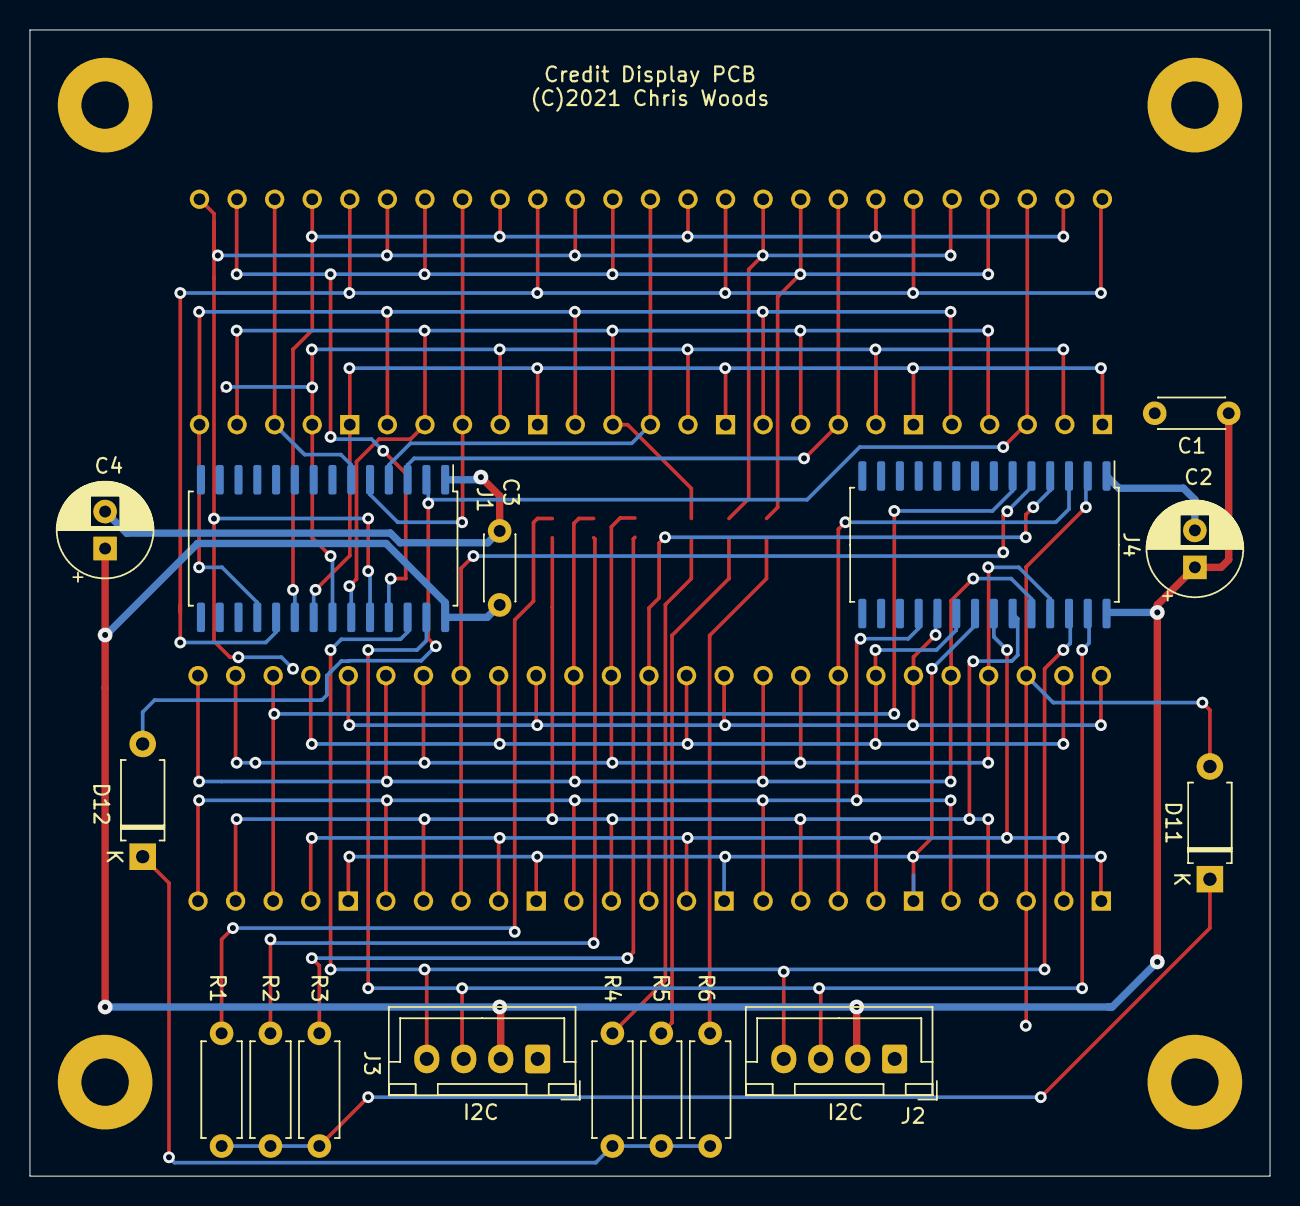
[picture p22: board anna_elsa_credit_display.kicad_pcb from below]

Board: 2 copper layers, 83.8 x 77.5 mm, 36 parts (16 on the bottom side), 38 nets.
