chris83527/anna_elsa_schematics/anna_elsa_esp32_cpu/anna_elsa_esp32_cpu.kicad_pcb

## KiCad design anna_elsa_esp32_cpu/anna_elsa_esp32_cpu.kicad_pcb (2023-09-29)

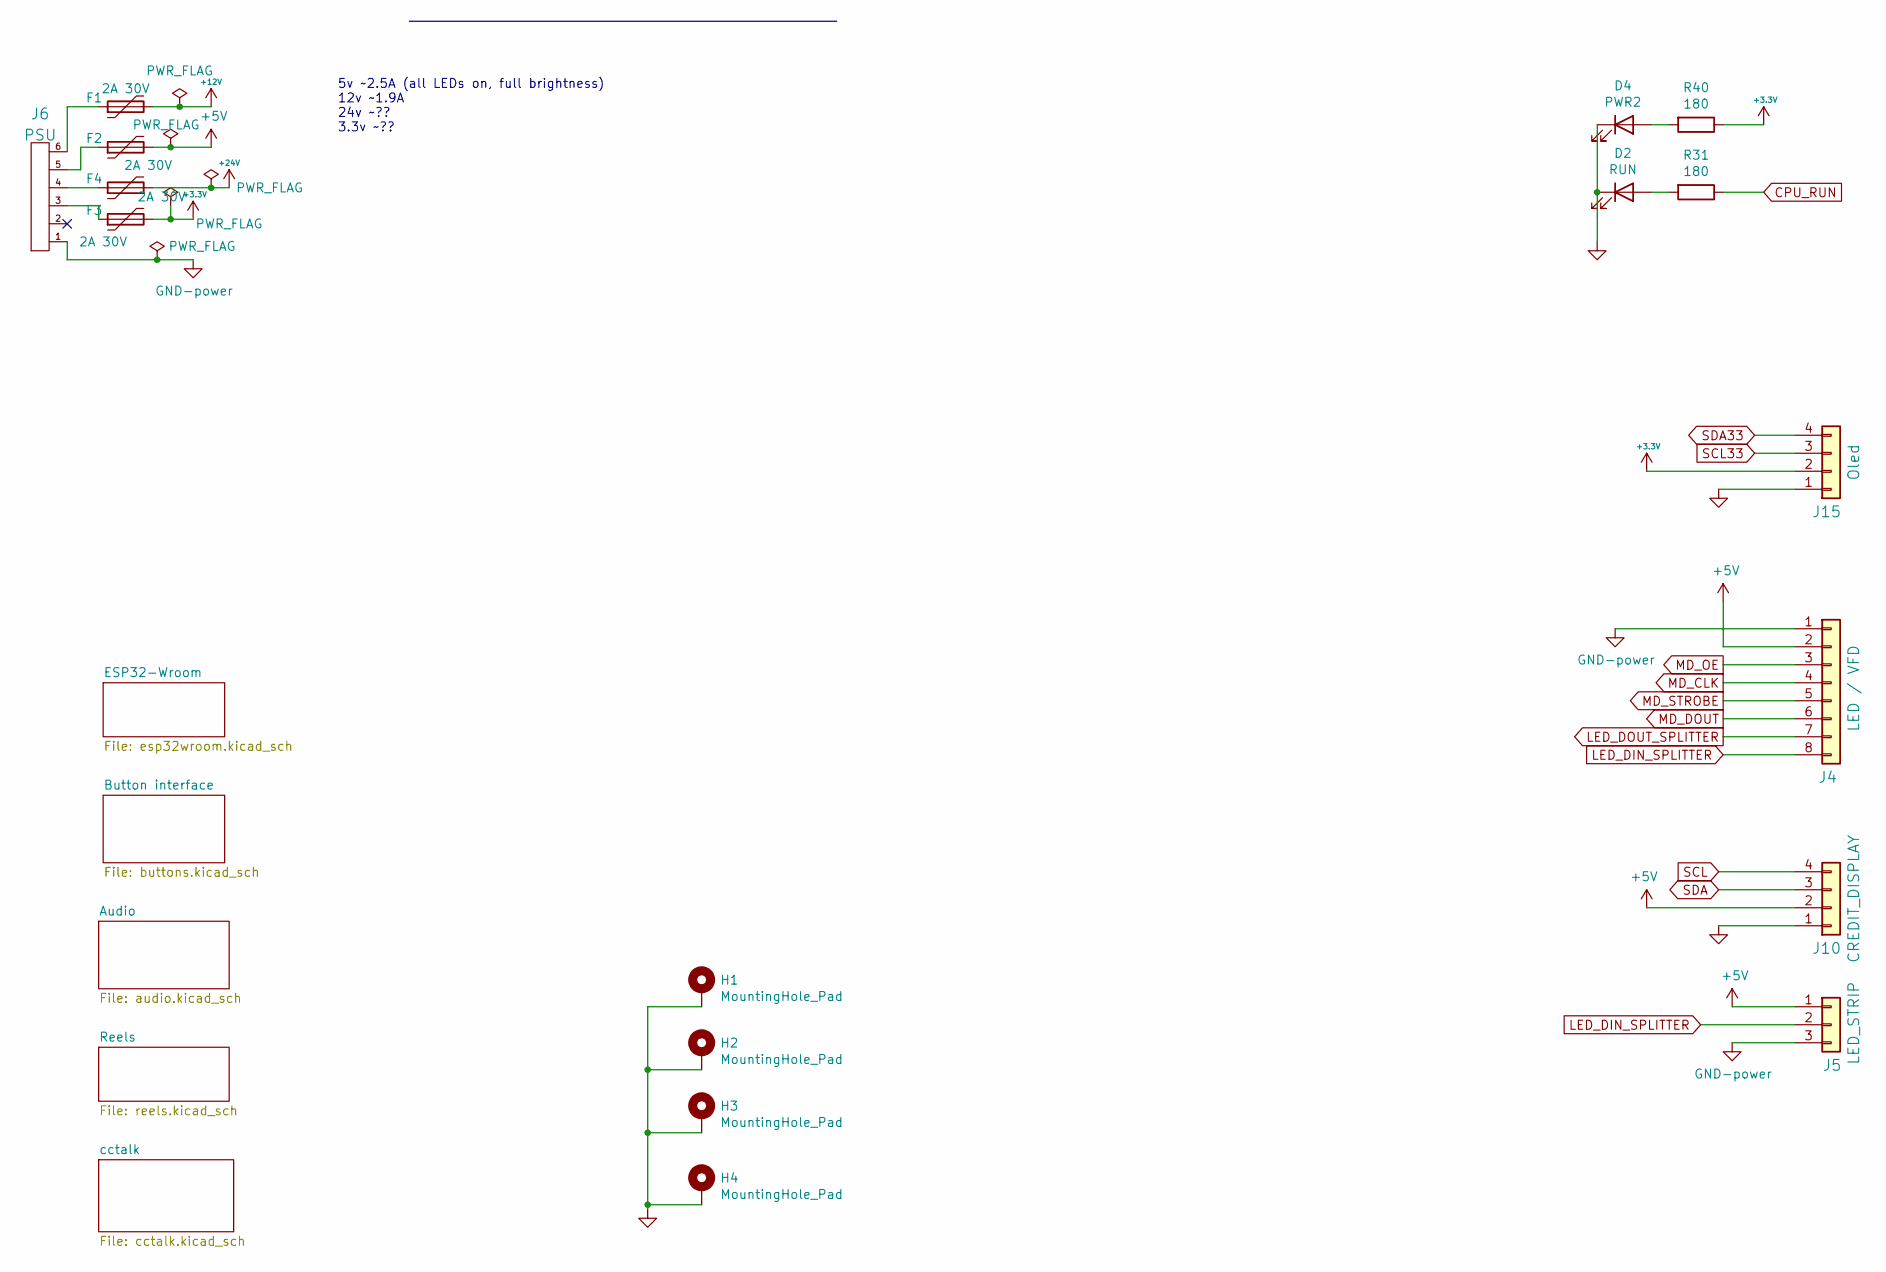
[picture p23: schematic anna_elsa_esp32_cpu.kicad_sch, System22 CPU]

Parts:
D2: RUN; LED_0805_2012Metric; MPN NCD0805R1; LCSC C84256
D4: PWR2; LED_0805_2012Metric; MPN NCD0805R1; LCSC C84256
F1, F2, F3, F4: 2A 30V; Fuse_1812_4532Metric; MPN BSMD1812-200-30V; LCSC C960026
H1, H2, H3, H4: MountingHole_Pad; MountingHole_3.2mm_M3_Pad_Via
J4: LED / VFD; JST_XH_B8B-XH-A_1x08_P2.50mm_Vertical
J5: LED_STRIP; JST_XH_B3B-XH-A_1x03_P2.50mm_Vertical
J6: PSU; PhoenixContact_MCV_1,5_6-G-3.5_1x06_P3.50mm_Vertical
J10: CREDIT_DISPLAY; JST_XH_B4B-XH-A_1x04_P2.50mm_Vertical
J15: Oled; PinSocket_1x04_P2.54mm_Vertical
R31, R40: 180; R_0805_2012Metric; MPN 0805W8F1800T5E; LCSC C25270

Connections:
+3.3V: F3.2, J15.2, R40.1; also elsewhere on the board
+5V: F2.2, J4.2, J5.1, J10.2; also elsewhere on the board
+12V: F1.2; also elsewhere on the board
+24V: F4.2; also elsewhere on the board
CPU_RUN: R31.1; also elsewhere on the board
LED_DIN_SPLITTER: J4.8, J5.2
LED_DOUT_SPLITTER: J4.7; also elsewhere on the board
MD_CLK: J4.4; also elsewhere on the board
MD_DOUT: J4.6; also elsewhere on the board
MD_OE: J4.3; also elsewhere on the board
MD_STROBE: J4.5; also elsewhere on the board
unnamed: D2.2 (A), R31.2
unnamed: D4.2 (A), R40.2
unnamed: F1.1, J6.6
unnamed: F2.1, J6.5
unnamed: F3.1, J6.3
unnamed: F4.1, J6.4
SCL: J10.4; also elsewhere on the board
SCL33: J15.3; also elsewhere on the board
SDA: J10.3; also elsewhere on the board
SDA33: J15.4; also elsewhere on the board

Notes on the sheet:
5v ~2.5A (all LEDs on, full brightness) 12v ~1.9A 24v ~?? 3.3v ~??

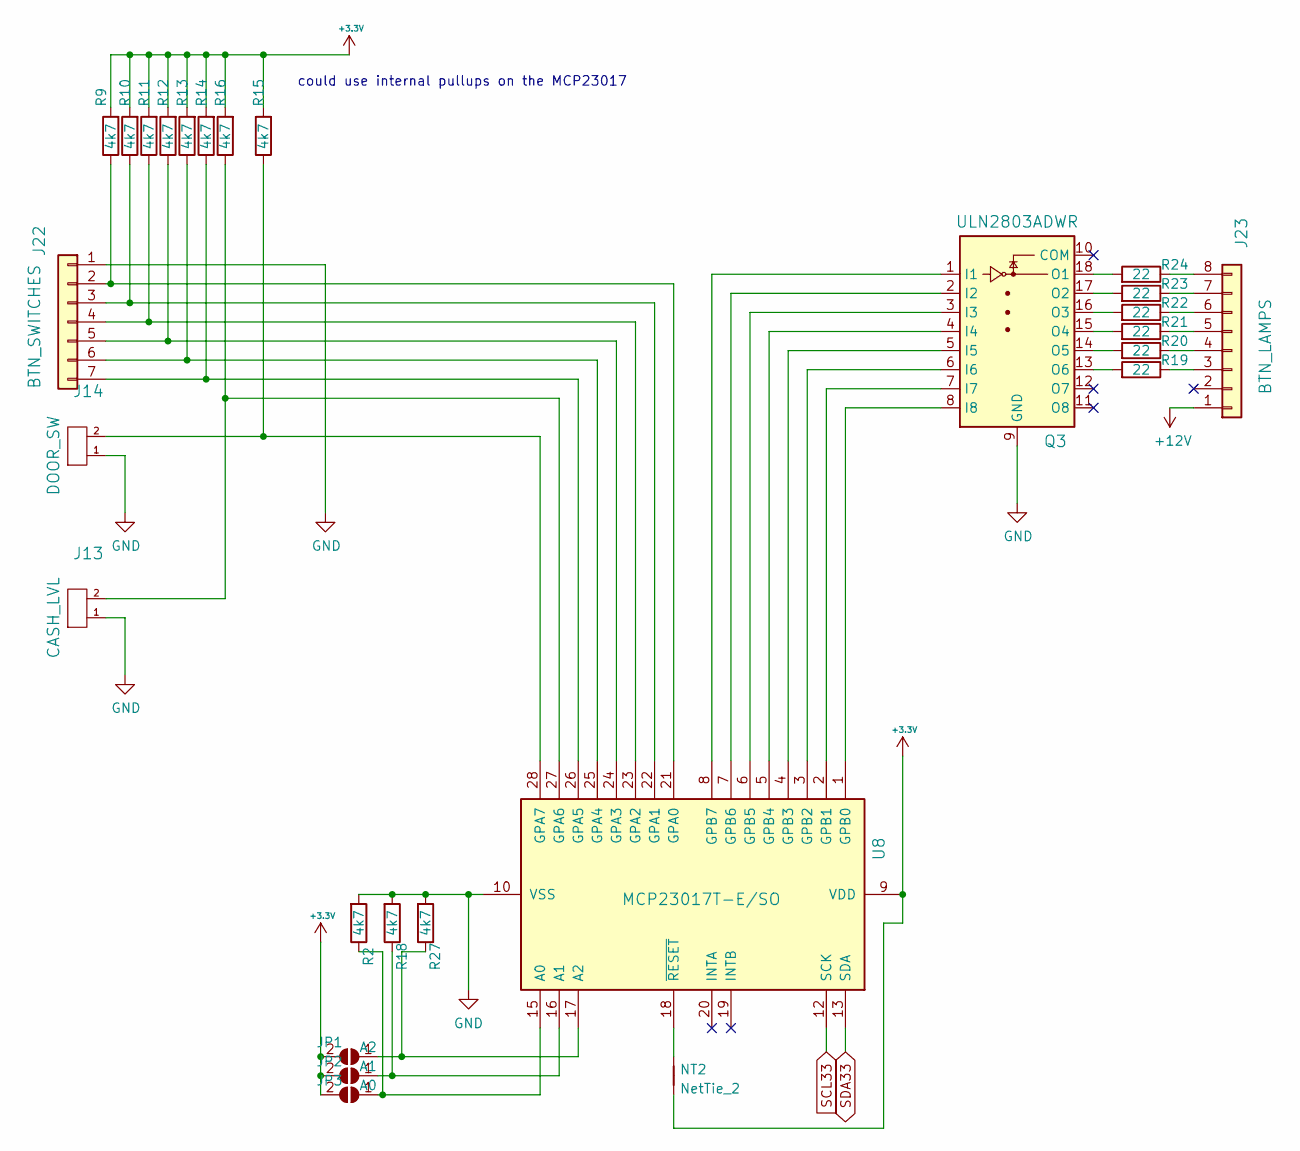
[picture p24: schematic buttons.kicad_sch, System22 CPU]

Parts:
J13: CASH_LVL; JST_XH_B2B-XH-A_1x02_P2.50mm_Vertical
J14: DOOR_SW; JST_XH_B2B-XH-A_1x02_P2.50mm_Vertical
J22: BTN_SWITCHES; JST_XH_B7B-XH-A_1x07_P2.50mm_Vertical
J23: BTN_LAMPS; JST_XH_B8B-XH-A_1x08_P2.50mm_Vertical
JP1: A2; SolderJumper-2_P1.3mm_Open_RoundedPad1.0x1.5mm
JP2: A1; SolderJumper-2_P1.3mm_Open_RoundedPad1.0x1.5mm
JP3: A0; SolderJumper-2_P1.3mm_Open_RoundedPad1.0x1.5mm
NT2: NetTie_2; NetTie-2_SMD_Pad0.5mm
Q3: ULN2803ADWR; SOIC-18W_7.5x11.6mm_P1.27mm; MPN ULN2803ADWR; Digi-Key_PN 296-15777-1-ND
R2, R9, R10, R11, R12, R13, R14, R15, R16, R18, R27: 4k7; R_0805_2012Metric; LCSC C17673
R19, R20, R21, R22, R23, R24: 22; R_0805_2012Metric; LCSC C17561
U8: MCP23017T-E/SO; SOIC-28W_7.5x17.9mm_P1.27mm; MPN MCP23017-E/SO; Digi-Key_PN MCP23017-E/SO-ND

Connections:
+3.3V: JP1.2 (B), JP2.2 (B), JP3.2 (B), NT2.1, R9.2, R10.2, R11.2, R12.2, R13.2, R14.2, R15.2, R16.2, U8.9 (VDD); also elsewhere on the board
+12V: J23.1; also elsewhere on the board
unnamed: J13.2, R16.1, U8.27 (GPA6)
unnamed: J14.2, R15.1, U8.28 (GPA7)
unnamed: J22.2, R9.1, U8.21 (GPA0)
unnamed: J22.3, R10.1, U8.22 (GPA1)
unnamed: J22.4, R11.1, U8.23 (GPA2)
unnamed: J22.5, R12.1, U8.24 (GPA3)
unnamed: J22.6, R13.1, U8.25 (GPA4)
unnamed: J22.7, R14.1, U8.26 (GPA5)
unnamed: J23.3, R19.1
unnamed: J23.4, R20.1
unnamed: J23.5, R21.1
unnamed: J23.6, R22.1
unnamed: J23.7, R23.1
unnamed: J23.8, R24.1
unnamed: JP1.1 (A), R27.1, U8.17 (A2)
unnamed: JP2.1 (A), R18.1, U8.16 (A1)
unnamed: JP3.1 (A), R2.1, U8.15 (A0)
unnamed: NT2.2, U8.18 (~RESET)
unnamed: Q3.1 (I1), U8.8 (GPB7)
unnamed: Q3.2 (I2), U8.7 (GPB6)
unnamed: Q3.3 (I3), U8.6 (GPB5)
unnamed: Q3.4 (I4), U8.5 (GPB4)
unnamed: Q3.5 (I5), U8.4 (GPB3)
unnamed: Q3.6 (I6), U8.3 (GPB2)
unnamed: Q3.7 (I7), U8.2 (GPB1)
unnamed: Q3.8 (I8), U8.1 (GPB0)
unnamed: Q3.13 (O6), R19.2
unnamed: Q3.14 (O5), R20.2
unnamed: Q3.15 (O4), R21.2
unnamed: Q3.16 (O3), R22.2
unnamed: Q3.17 (O2), R23.2
unnamed: Q3.18 (O1), R24.2
SCL33: U8.12 (SCK); also elsewhere on the board
SDA33: U8.13 (SDA); also elsewhere on the board

Notes on the sheet:
could use internal pullups on the MCP23017
