chris83527/anna_elsa_schematics/anna_elsa_esp32_cpu/anna_elsa_esp32_cpu.kicad_pcb

## KiCad design anna_elsa_esp32_cpu/anna_elsa_esp32_cpu.kicad_pcb (continued)

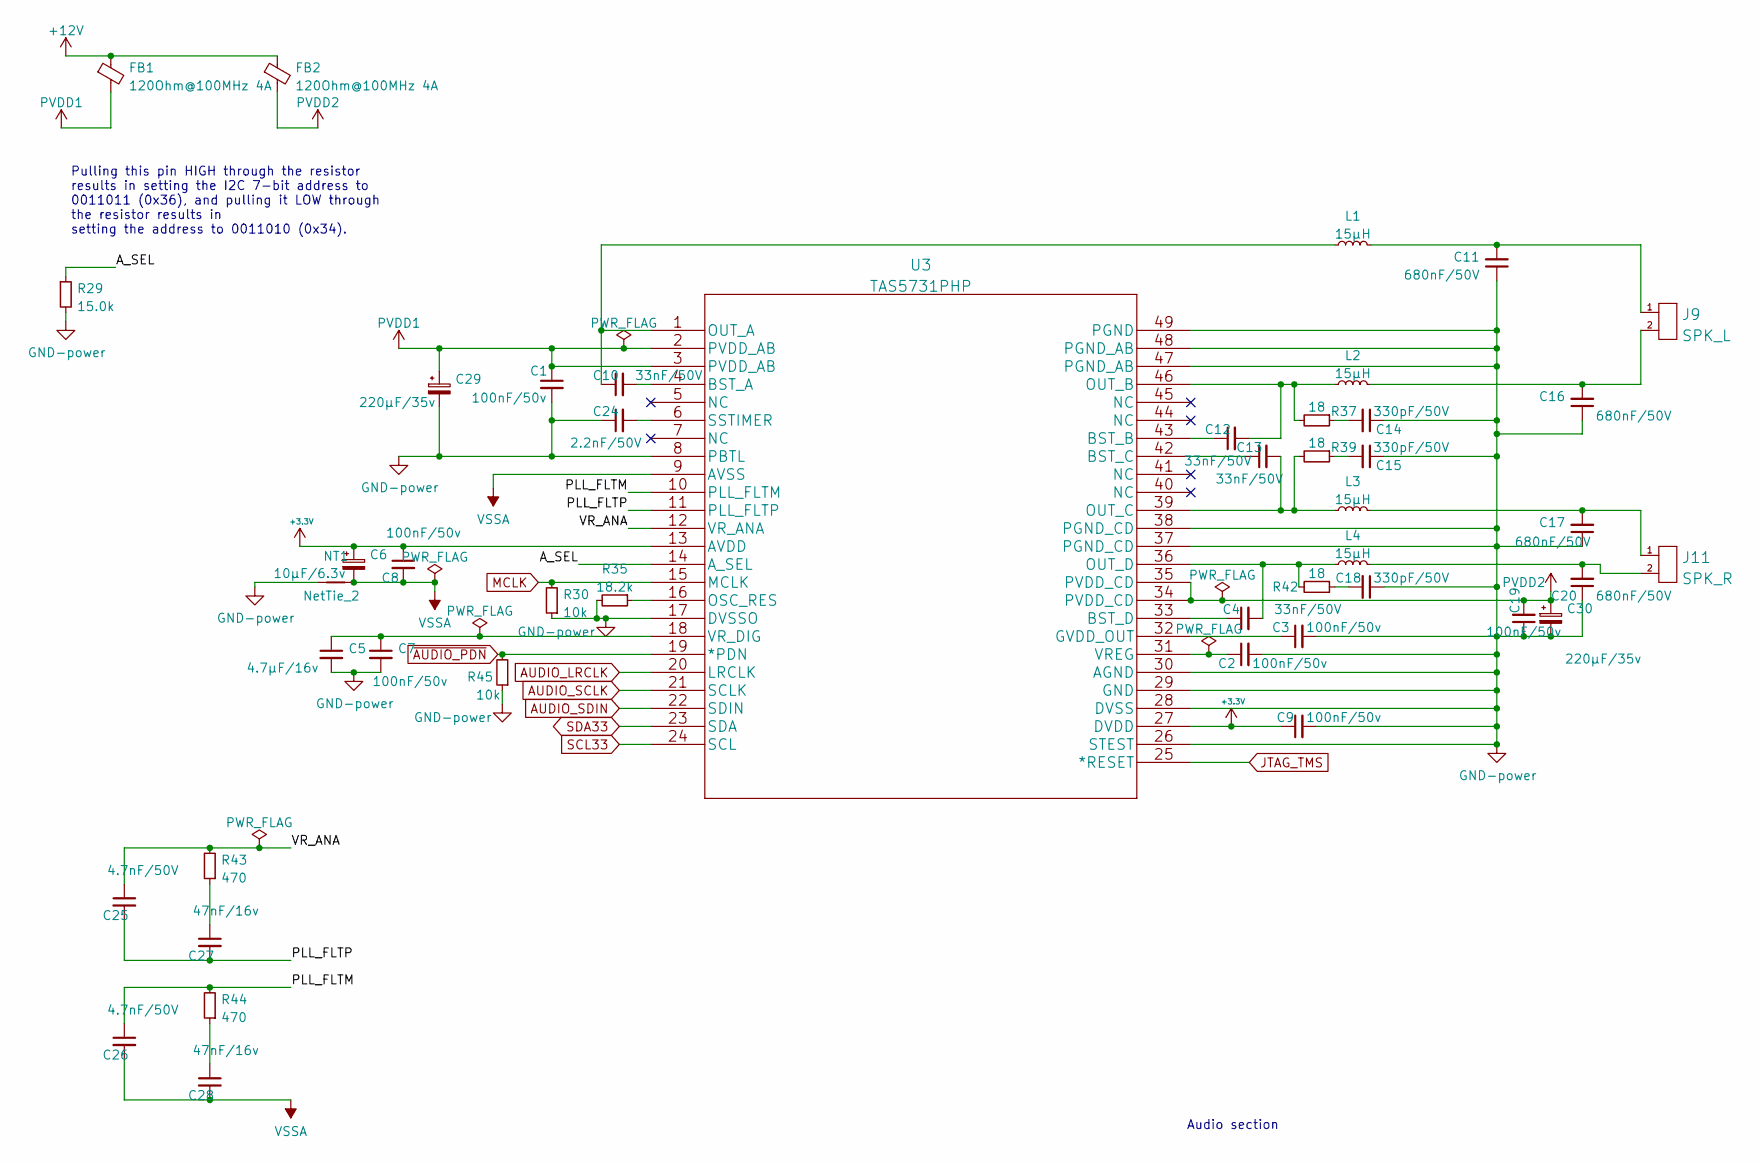
[picture p25: schematic audio.kicad_sch, System22 CPU]

Parts:
C1: 100nF/50v; C_0603_1608Metric; MPN CC0603KRX7R9BB104; LCSC C14663
C2, C3, C7, C8, C9, C19: 100nF/50v; C_0603_1608Metric; MPN CC0603KRX7R9BB104; JLC 0603
C4, C10, C12, C13: 33nF/50V; C_0603_1608Metric; MPN CL10B333KB8NNNC; JLC 0603
C5: 4.7µF/16v; C_0603_1608Metric; MPN CL10A475KO8NNNC; JLC 0603
C6: 10µF/6.3v; CP_Elec_4x5.4; MPN EEE1CA100SR; JLC 4x5.4mm
C11, C16, C17, C20: 680nF/50V; C_1206_3216Metric; MPN 1206B684K500CT; JLC 1206
C14, C15, C18: 330pF/50V; C_0603_1608Metric; MPN CL10C331JB8NNNC; JLC 0603
C24: 2.2nF/50V; C_0603_1608Metric; MPN CL10B221KB8NNNC; LCSC C107082
C25, C26: 4.7nF/50V; C_0603_1608Metric; MPN 0603B472K500NT; JLC 0603
C27, C28: 47nF/16v; C_0603_1608Metric; MPN CC0603KRX7R9BB473; JLC 0603
C29: 220µF/35v; C_Elec_8x10.2; MPN EEEFK1V221P; JLC C724731
C30: 220µF/35v; C_Elec_8x10.2; MPN EEEFK1V221P; LCSC C724731
FB1, FB2: 120Ohm@100MHz 4A; L_1206_3216Metric; MPN HCB3216KF-121T40; JLC 1206
J9: SPK_L; JST_XH_B2B-XH-A_1x02_P2.50mm_Vertical
J11: SPK_R; JST_XH_B2B-XH-A_1x02_P2.50mm_Vertical
L1, L2, L3, L4: 15µH; L_SigTra_SC3316F; MPN SSL0804HC-150M-N; LCSC C329909
NT1: NetTie_2; NetTie-2_SMD_Pad0.5mm
R29: 15.0k; R_0603_1608Metric; MPN 0603WAF1502T5E; JLC 0603
R30, R45: 10k; R_0603_1608Metric; MPN 0603WAF1002T5E; JLC 0603
R35: 18.2k; R_0603_1608Metric; MPN 0603WAF1822T5E; JLC 0603
R37, R39, R42: 18; R_0603_1608Metric; MPN 0603WAF180JT5E; JLC 0603
R43, R44: 470; R_0603_1608Metric; MPN 0603WAF4700T5E; JLC 0603
U3: TAS5731PHP; TQFP-48-1EP_7x7mm_P0.5mm_EP5x5mm_ThermalVias; MPN TAS5731MPHPR; JLC TQFP-48_7x7x05P

Connections:
+3.3V: C6.1, C8.1, C9.1, U3.13 (AVDD), U3.27 (DVDD); also elsewhere on the board
+12V: FB1.1, FB2.1; also elsewhere on the board
/Audio/A_SEL: R29.1, U3.14 (A_SEL)
/Audio/PLL_FLTM: C26.1, R44.2, U3.10 (PLL_FLTM)
/Audio/PLL_FLTP: C25.2, C27.2, U3.11 (PLL_FLTP)
/Audio/VR_ANA: C25.1, R43.2, U3.12 (VR_ANA)
AUDIO_LRCLK: U3.20 (LRCLK); also elsewhere on the board
AUDIO_SCLK: U3.21 (SCLK); also elsewhere on the board
AUDIO_SDIN: U3.22 (SDIN); also elsewhere on the board
JTAG_TMS: U3.25 (*RESET); also elsewhere on the board
MCLK: R30.2, U3.15 (MCLK); also elsewhere on the board
unnamed: C2.1, U3.31 (VREG)
unnamed: C3.1, U3.32 (GVDD_OUT)
unnamed: C4.1, U3.33 (BST_D)
unnamed: C4.2, L4.1, R42.2, U3.36 (OUT_D)
unnamed: C5.1, C7.1, U3.18 (VR_DIG)
unnamed: C10.1, L1.1, U3.1 (OUT_A)
unnamed: C10.2, U3.4 (BST_A)
unnamed: C11.2, J9.1, L1.2
unnamed: C12.1, U3.43 (BST_B)
unnamed: C12.2, L2.1, R37.2, U3.46 (OUT_B)
unnamed: C13.1, U3.42 (BST_C)
unnamed: C13.2, L3.1, R39.2, U3.39 (OUT_C)
unnamed: C14.2, R37.1
unnamed: C15.2, R39.1
unnamed: C16.2, J9.2, L2.2
unnamed: C17.2, J11.1, L3.2
unnamed: C18.2, R42.1
unnamed: C20.2, J11.2, L4.2
unnamed: C24.2, U3.6 (SSTIMER)
unnamed: C27.1, R43.1
unnamed: C28.1, R44.1
unnamed: R35.1, U3.16 (OSC_RES)
PVDD1: C1.1, C29.1, FB1.2, U3.2 (PVDD_AB), U3.3 (PVDD_AB)
PVDD2: C19.2, C30.1, FB2.2, U3.34 (PVDD_CD), U3.35 (PVDD_CD)
SCL33: U3.24 (SCL); also elsewhere on the board
SDA33: U3.23 (SDA); also elsewhere on the board
VSSA: C6.2, C8.2, C26.2, C28.2, NT1.2, U3.9 (AVSS)
~AUDIO_PDN: R45.2, U3.19 (*PDN); also elsewhere on the board

Notes on the sheet:
Audio section
Pulling this pin HIGH through the resistor results in setting the I2C 7-bit address to 0011011 (0x36), and pulling it LOW through the resistor results in setting the address to 0011010 (0x34).

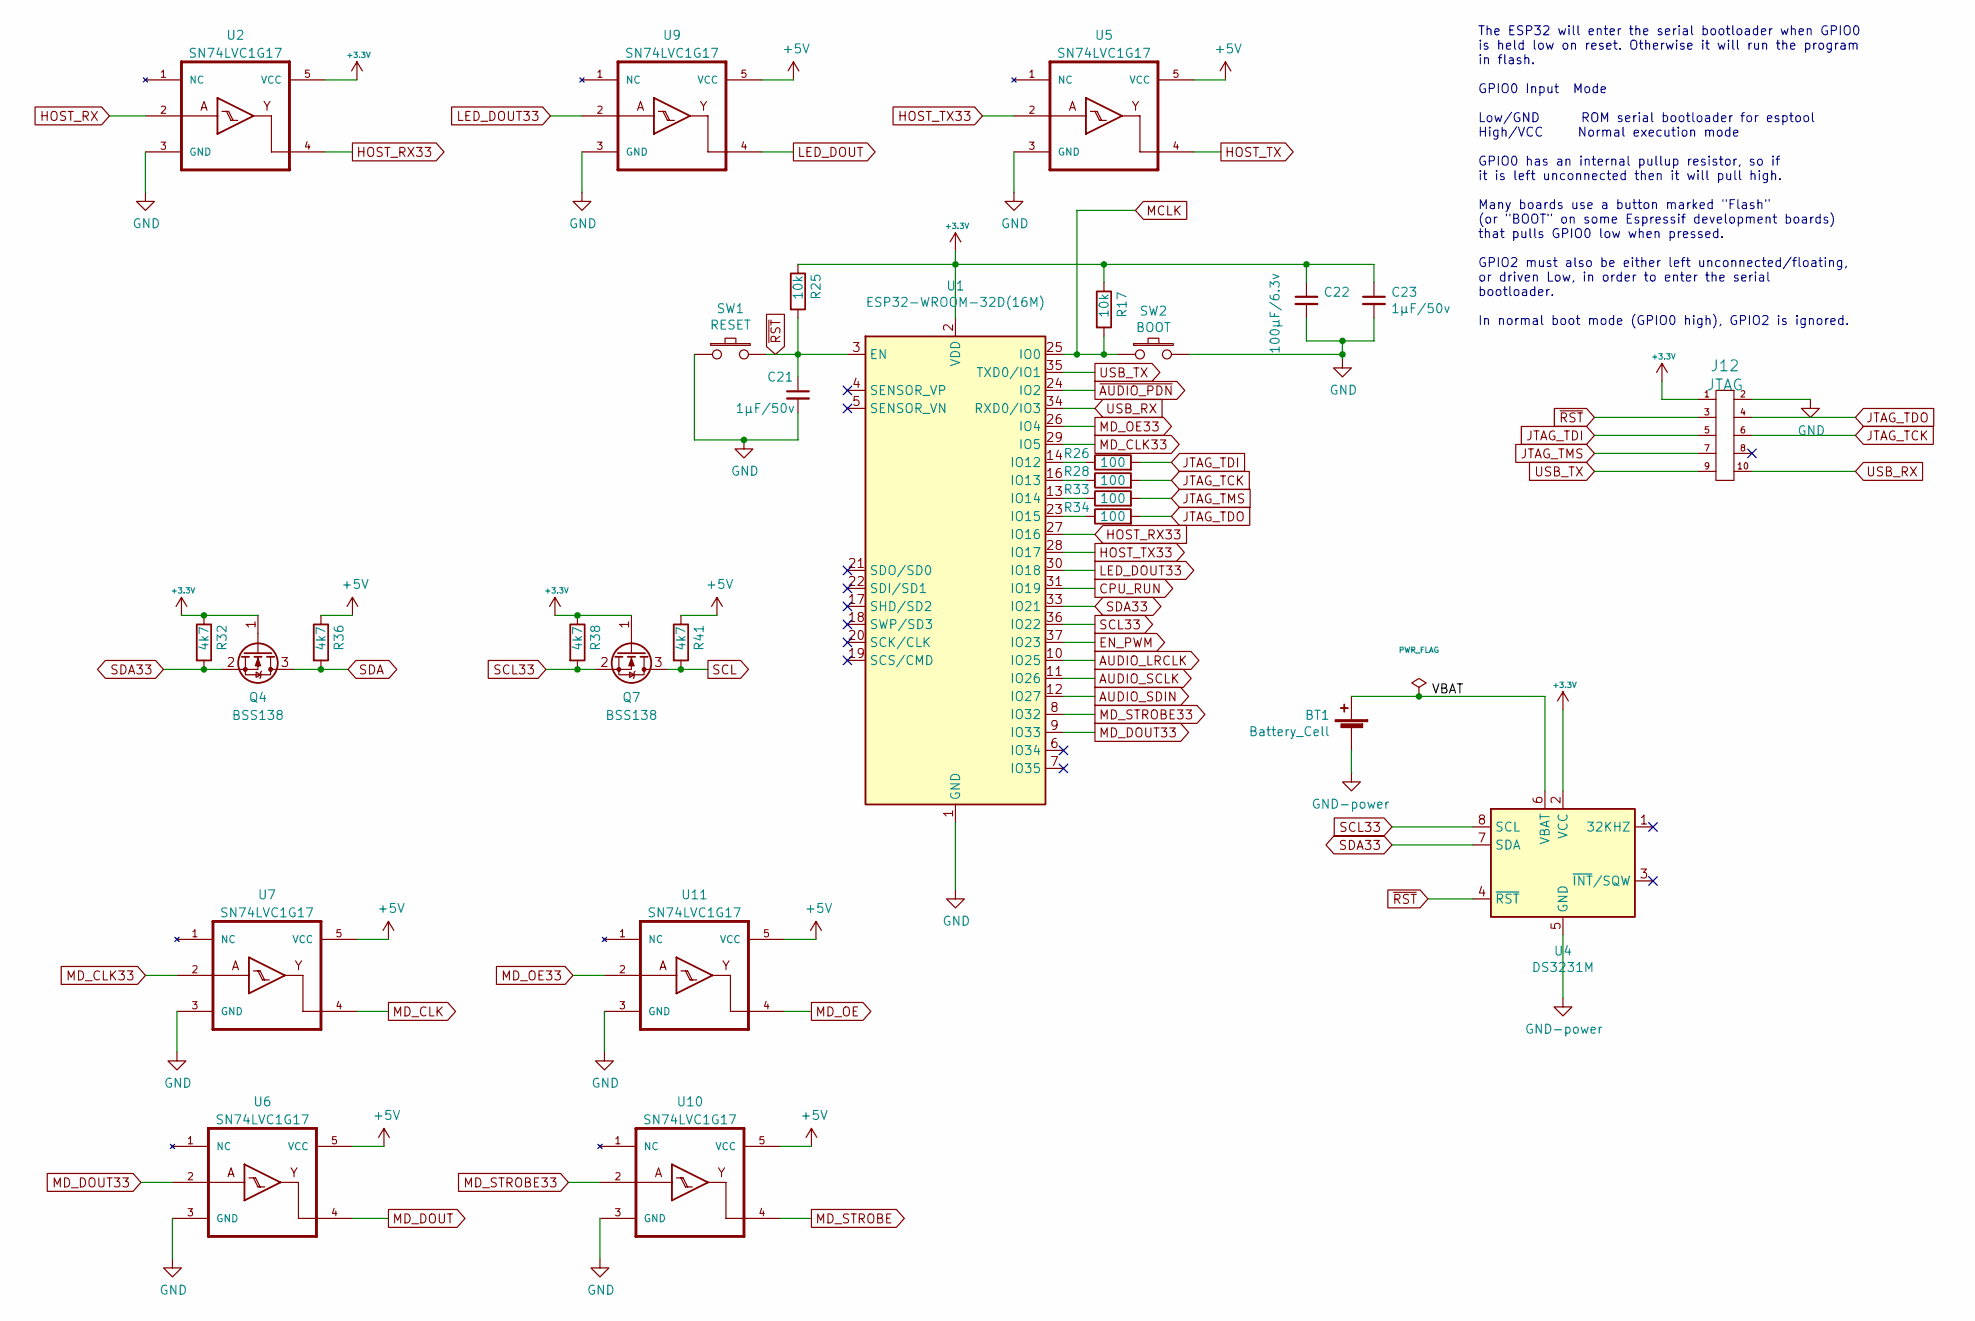
[picture p26: schematic esp32wroom.kicad_sch, System22 CPU]

Parts:
BT1: Battery_Cell; BatteryHolder_Keystone_1060_1x2032; JLC SMD
C21, C23: 1µF/50v; C_0805_2012Metric; MPN CL21B105KBFNNNE; LCSC C28323
C22: 100µF/6.3v; C_1206_3216Metric; MPN CL31A107MQHNNNE; LCSC C15008
J12: JTAG; IDC-Header_2x05_P2.54mm_Vertical
Q4, Q7: BSS138; SOT-23; MPN BSS138L; LCSC C890265
R17, R25: 10k; R_0603_1608Metric; MPN 0603WAF1002T5E; LCSC C25804
R26, R28, R33, R34: 100; R_0603_1608Metric; MPN 0603WAF1000T5E; LCSC C22775
R32, R36, R38, R41: 4k7; R_0603_1608Metric; MPN MCR03EZPJ472; LCSC C123022
SW1: RESET; SW_SPST_Omron_B3FS-100xP; MPN B3FS-1002P; JLC 6x3.1mm
SW2: BOOT; SW_SPST_Omron_B3FS-100xP; MPN B3FS-1002P; JLC 6x3.1mm
U1: ESP32-WROOM-32D(16M); ESP32-WROOM-32; MPN ESP32-WROOM-32D(16MB); LCSC C529578
U2: SN74LVC1G17; SOT-353_SC-70-5; MPN SN74LVC1G17DCKR; LCSC C10425
U4: DS3231M; SOIC-8_3.9x4.9mm_P1.27mm; MPN DS3231MZ+TRL; LCSC C107410
U5, U6, U10, U11: SN74LVC1G17; SOT-353_SC-70-5; LCSC C10425
U7: SN74LVC1G17; SOT-353_SC-70-5; MPN SN74LVC1G17QDBVRQ1; LCSC C10425
U9: SN74LVC1G17; SOT-353_SC-70-5; MPN SN74LVC1G17QDBVRQ; LCSC C10425

Connections:
+3.3V: C22.1, C23.1, J12.1, Q4.1 (G), Q7.1 (G), R17.1, R25.1, R32.1, R38.1, U1.2 (VDD), U2.5 (VCC), U4.2 (VCC); also elsewhere on the board
+5V: R36.1, R41.1, U5.5 (VCC), U6.5 (VCC), U7.5 (VCC), U9.5 (VCC), U10.5 (VCC), U11.5 (VCC); also elsewhere on the board
/ESP32-Wroom/VBAT: BT1.1 (+), U4.6 (VBAT)
AUDIO_LRCLK: U1.10 (IO25); also elsewhere on the board
AUDIO_SCLK: U1.11 (IO26); also elsewhere on the board
AUDIO_SDIN: U1.12 (IO27); also elsewhere on the board
CPU_RUN: U1.31 (IO19); also elsewhere on the board
EN_PWM: U1.37 (IO23); also elsewhere on the board
HOST_RX: U2.2; also elsewhere on the board
HOST_RX33: U1.27 (IO16), U2.4
HOST_TX: U5.4; also elsewhere on the board
HOST_TX33: U1.28 (IO17), U5.2
JTAG_TCK: J12.6, R28.2
JTAG_TDI: J12.5, R26.2
JTAG_TDO: J12.4, R34.2
JTAG_TMS: J12.7, R33.2; also elsewhere on the board
LED_DOUT: U9.4; also elsewhere on the board
LED_DOUT33: U1.30 (IO18), U9.2
MCLK: R17.2, SW2.1, U1.25 (IO0); also elsewhere on the board
MD_CLK: U7.4; also elsewhere on the board
MD_CLK33: U1.29 (IO5), U7.2
MD_DOUT: U6.4; also elsewhere on the board
MD_DOUT33: U1.9 (IO33), U6.2
MD_OE: U11.4; also elsewhere on the board
MD_OE33: U1.26 (IO4), U11.2
MD_STROBE: U10.4; also elsewhere on the board
MD_STROBE33: U1.8 (IO32), U10.2
unnamed: R26.1, U1.14 (IO12)
unnamed: R28.1, U1.16 (IO13)
unnamed: R33.1, U1.13 (IO14)
unnamed: R34.1, U1.23 (IO15)
SCL: Q7.3 (D), R41.2; also elsewhere on the board
SCL33: Q7.2 (S), R38.2, U1.36 (IO22), U4.8 (SCL); also elsewhere on the board
SDA: Q4.3 (D), R36.2; also elsewhere on the board
SDA33: Q4.2 (S), R32.2, U1.33 (IO21), U4.7 (SDA); also elsewhere on the board
USB_RX: J12.10, U1.34 (RXD0/IO3)
USB_TX: J12.9, U1.35 (TXD0/IO1)
~AUDIO_PDN: U1.24 (IO2); also elsewhere on the board
~RST: C21.1, J12.3, R25.2, SW1.2, U1.3 (EN), U4.4 (~RST)

Notes on the sheet:
The ESP32 will enter the serial bootloader when GPIO0 is held low on reset. Otherwise it will run the program in flash. GPIO0 Input Mode Low/GND ROM serial bootloader for esptool High/VCC Normal execution mode GPIO0 has an internal pullup resistor, so if it is left unconnected then it will pull hig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

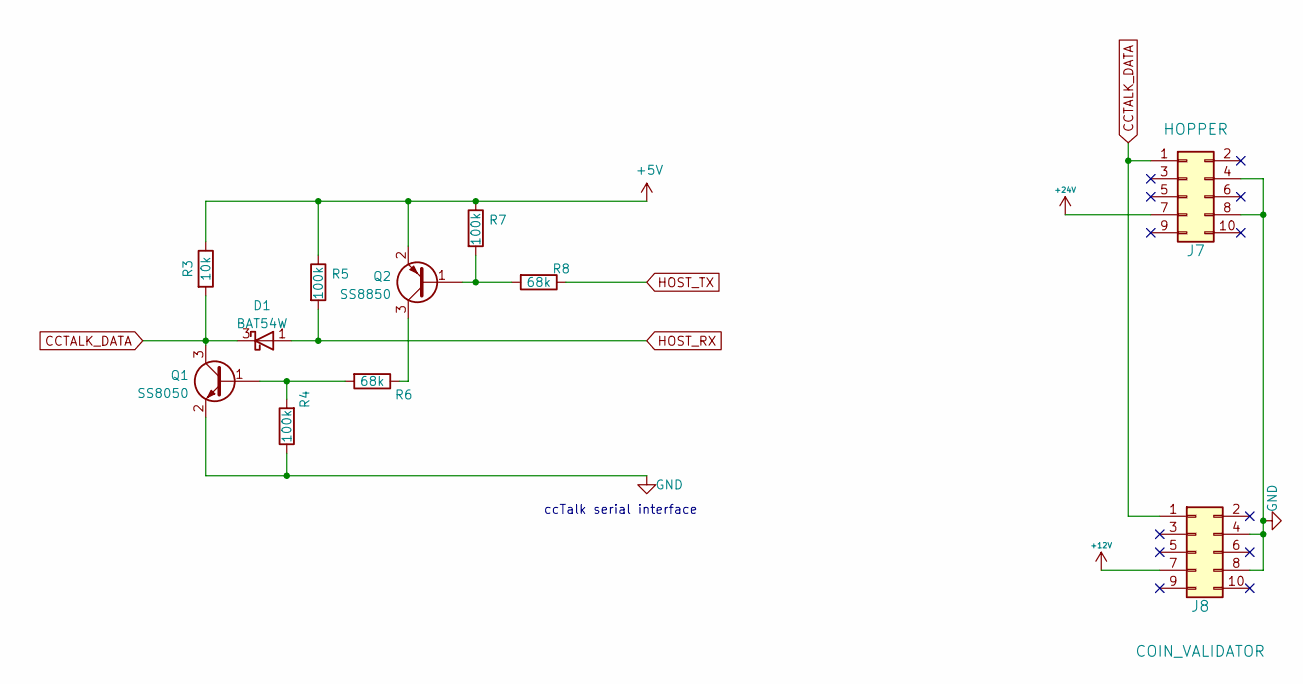
[picture p27: schematic cctalk.kicad_sch, System22 CPU]

Parts:
D1: BAT54W; SOT-323_SC-70
J7: HOPPER; IDC-Header_2x05_P2.54mm_Vertical
J8: COIN_VALIDATOR; IDC-Header_2x05_P2.54mm_Vertical
Q1: SS8050; SOT-23; LCSC C2150
Q2: SS8850; SOT-23; MPN SS8550 Y2; LCSC C8542
R3: 10k; R_0603_1608Metric; MPN 0603WAF1002T5E; LCSC C25804
R4, R5, R7: 100k; R_0805_2012Metric; MPN 0805W8F100KT5E; LCSC C280011
R6, R8: 68k; R_0805_2012Metric; LCSC C17801

Connections:
+5V: Q2.2 (E), R3.1, R5.1, R7.1; also elsewhere on the board
+12V: J8.7; also elsewhere on the board
+24V: J7.7; also elsewhere on the board
CCTALK_DATA: D1.3 (K), J7.1, J8.1, Q1.3 (C), R3.2
HOST_RX: D1.1 (A), R5.2; also elsewhere on the board
HOST_TX: R8.1; also elsewhere on the board
unnamed: Q1.1 (B), R4.2, R6.2
unnamed: Q2.1 (B), R7.2, R8.2
unnamed: Q2.3 (C), R6.1

Notes on the sheet:
ccTalk serial interface

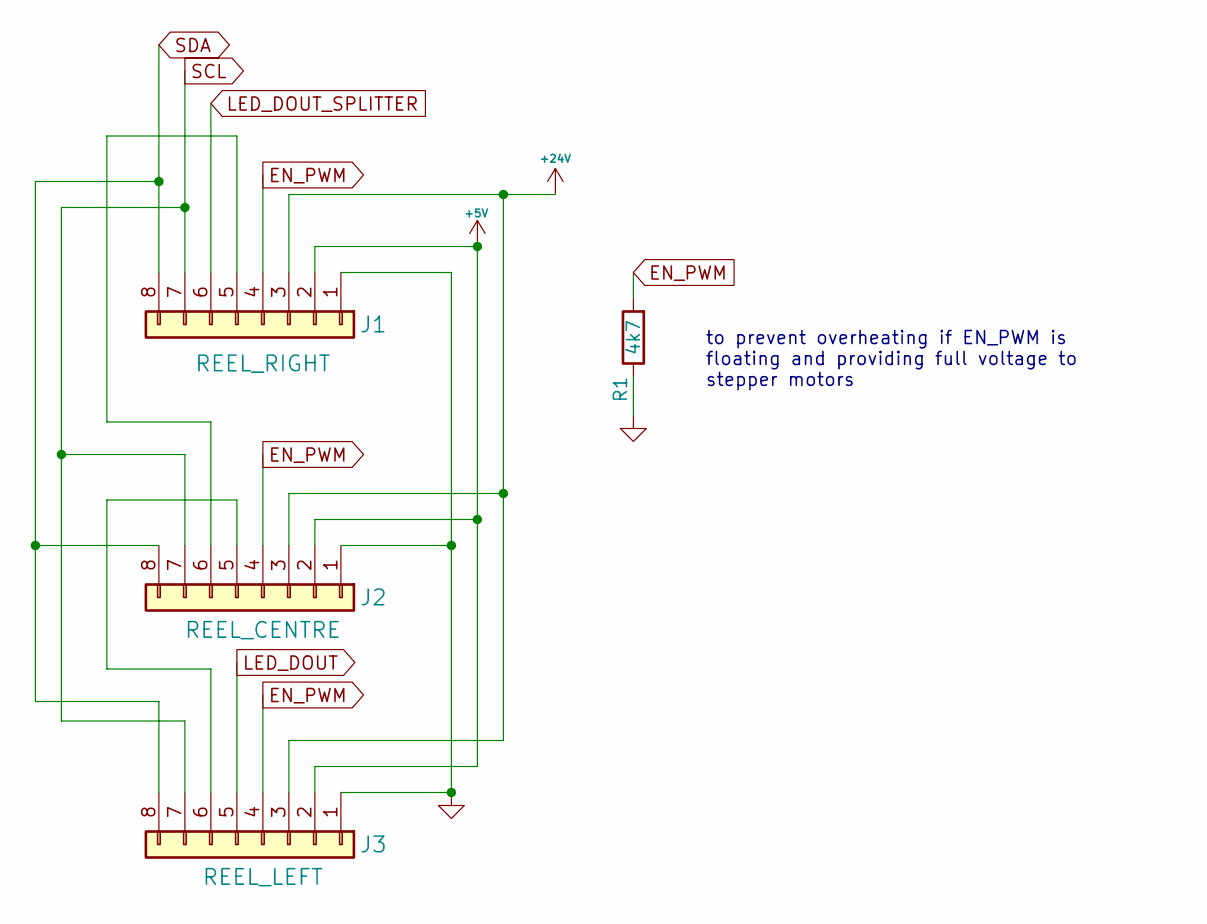
[picture p28: schematic reels.kicad_sch, System22 CPU]

Parts:
J1: REEL_RIGHT; JST_XH_B8B-XH-A_1x08_P2.50mm_Vertical
J2: REEL_CENTRE; JST_XH_B8B-XH-A_1x08_P2.50mm_Vertical
J3: REEL_LEFT; JST_XH_B8B-XH-A_1x08_P2.50mm_Vertical
R1: 4k7; R_0805_2012Metric; LCSC C17673

Connections:
+5V: J1.2, J2.2, J3.2; also elsewhere on the board
+24V: J1.3, J2.3, J3.3; also elsewhere on the board
EN_PWM: J1.4, J2.4, J3.4, R1.2; also elsewhere on the board
LED_DOUT: J3.5; also elsewhere on the board
LED_DOUT_SPLITTER: J1.6; also elsewhere on the board
unnamed: J1.5, J2.6
unnamed: J2.5, J3.6
SCL: J1.7, J2.7, J3.7; also elsewhere on the board
SDA: J1.8, J2.8, J3.8; also elsewhere on the board

Notes on the sheet:
to prevent overheating if EN_PWM is floating and providing full voltage to stepper motors

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
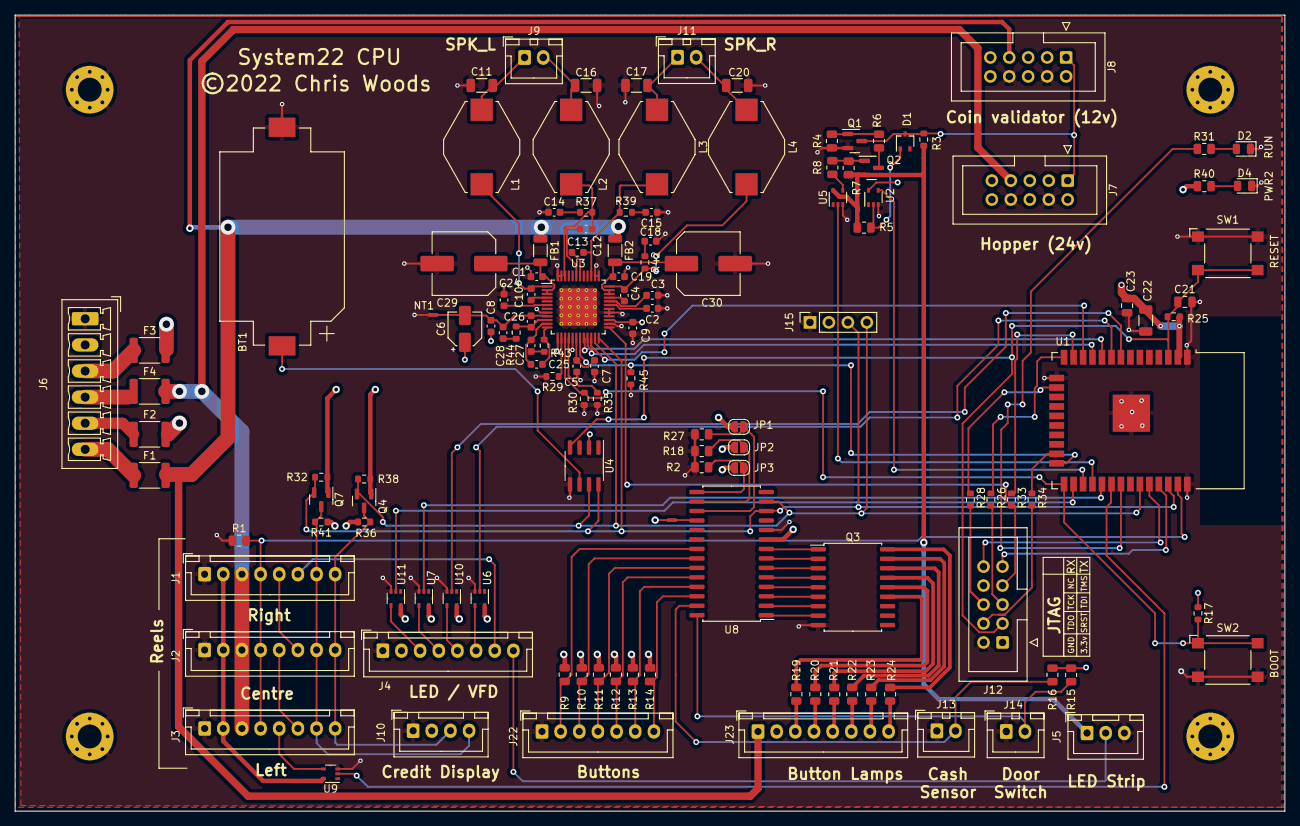
[picture p29: board anna_elsa_esp32_cpu.kicad_pcb from above]

Board: 4 copper layers, 170.2 x 106.7 mm, 133 parts (0 on the bottom side), 117 nets.
