chris83527/anna_elsa_schematics/anna_elsa_reel_pcb/anna_elsa_reel_pcb.kicad_pcb

## KiCad design anna_elsa_reel_pcb/anna_elsa_reel_pcb.kicad_pcb (2022-08-02)

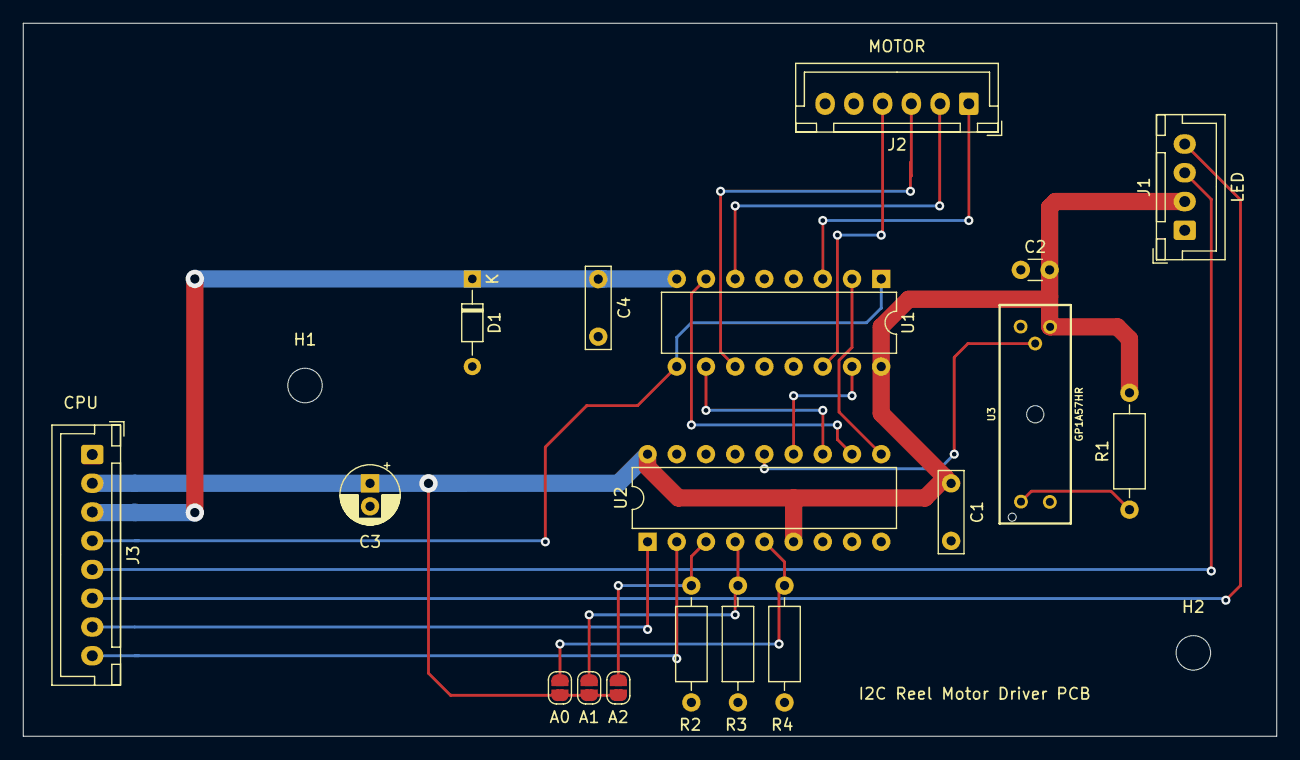
[picture p30: board anna_elsa_reel_pcb.kicad_pcb from above]

Board: 2 copper layers, 109.0 x 62.0 mm, 20 parts (0 on the bottom side), 21 nets.

Parts:
C1, C4: 100nF; C_Rect_L7.0mm_W2.0mm_P5.00mm
C2: 100nF; C_Disc_D3.0mm_W1.6mm_P2.50mm
C3: 10µF; CP_Radial_D5.0mm_P2.00mm
D1: D; D_DO-34_SOD68_P7.62mm_Horizontal
H1, H2: MountingHole; MountingHole_3mm
J1: LED; JST_XH_B4B-XH-A_1x04_P2.50mm_Vertical
J2: MOTOR; JST_XH_B6B-XH-A_1x06_P2.50mm_Vertical
J3: CPU; JST_XH_B8B-XH-A_1x08_P2.50mm_Vertical
JP1: A2; SolderJumper-2_P1.3mm_Open_RoundedPad1.0x1.5mm
JP2: A1; SolderJumper-2_P1.3mm_Open_RoundedPad1.0x1.5mm
JP3: A0; SolderJumper-2_P1.3mm_Open_RoundedPad1.0x1.5mm
R1: 180; R_Axial_DIN0207_L6.3mm_D2.5mm_P10.16mm_Horizontal
R2, R3, R4: 4k7; R_Axial_DIN0207_L6.3mm_D2.5mm_P10.16mm_Horizontal
U1: L293D; DIP-16_W7.62mm
U2: MCP23008-xP; DIP-18_W7.62mm
U3: GP1A57HR

Connections:
+5V: C1.1, C2.1, C3.1, J1.2, J3.2, JP1.1, JP2.1, JP3.1, R1.2, U1.16, U2.6, U2.18, U3.3
+24V: C4.1, D1.1, J3.3, U1.8
/EN_PWM: J3.4, U1.1, U1.9
/LED_DIN: J1.4, J3.6
/LED_DOUT: J1.3, J3.5
/M1_IN: U1.2, U2.10
/M1_OUT: J2.1, U1.3
/M2_IN: U1.7, U2.11
/M2_OUT: J2.2, U1.6
/M3_IN: U1.10, U2.12
/M3_OUT: J2.3, U1.11
/M4_IN: U1.15, U2.13
/M4_OUT: J2.4, U1.14
/PHOTOINTERRUPTER: U2.14, U3.4
/SCL: J3.7, U2.1
/SDA: J3.8, U2.2
GND: C1.2, C2.2, C3.2, C4.2, D1.2, J1.1, J3.1, R2.1, R3.1, R4.1, U1.4, U1.5, U1.12, U1.13, U2.9, U3.2, U3.5
unnamed: JP1.2, R2.2, U2.3
unnamed: JP2.2, R3.2, U2.4
unnamed: JP3.2, R4.2, U2.5
unnamed: R1.1, U3.1
