chris83527/anna_elsa_schematics/(commit log)

2022-08-02 removed redundant subdirectory
    [anna_elsa_displaydriver.kicad_sch, anna_elsa_displaydriver.sch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]
2022-08-02 Added additional schematics
    [anna_elsa_credit_display-B_Cu.gbr, anna_elsa_credit_display-B_Mask.gbr, anna_elsa_credit_display-B_Paste.gbr, anna_elsa_credit_display-B_SilkS.gbr, anna_elsa_credit_display-Edge_Cuts.gbr, anna_elsa_credit_display-F_Cu.gbr, anna_elsa_credit_display-F_Mask.gbr, anna_elsa_credit_display-F_Paste.gbr]
2022-08-02 Removed gerbers from reel pcb directory
    [anna_elsa_reel_pcb-B_Cu.gbr, anna_elsa_reel_pcb-B_Mask.gbr, anna_elsa_reel_pcb-B_Paste.gbr, anna_elsa_reel_pcb-B_SilkS.gbr, anna_elsa_reel_pcb-Edge_Cuts.gbr, anna_elsa_reel_pcb-F_Cu.gbr, anna_elsa_reel_pcb-F_Mask.gbr, anna_elsa_reel_pcb-F_Paste.gbr]
2022-08-02 Renamed plots directory to gerbers for consistency
    [anna_elsa_moves_display-B_Cu.gbr, anna_elsa_moves_display-B_Mask.gbr, anna_elsa_moves_display-B_Paste.gbr, anna_elsa_moves_display-B_SilkS.gbr, anna_elsa_moves_display-Edge_Cuts.gbr, anna_elsa_moves_display-F_Cu.gbr, anna_elsa_moves_display-F_Mask.gbr, anna_elsa_moves_display-F_Paste.gbr]
2022-08-02 Removed obsolete schematics
    [anna_elsa_displaydriver.kicad_sch, anna_elsa_displaydriver.sch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]
2023-01-22 Added current cpu pcb and removed old
    [anna_elsa_esp32_cpu-B_Cu.gbr, anna_elsa_esp32_cpu-Edge_Cuts.gbr, anna_elsa_esp32_cpu-F_Cu.gbr, anna_elsa_esp32_cpu-F_Mask.gbr, anna_elsa_esp32_cpu-F_Paste.gbr, anna_elsa_esp32_cpu-F_Silkscreen.gbr, anna_elsa_esp32_cpu-In1_Cu.gbr, anna_elsa_esp32_cpu-In2_Cu.gbr]
2023-01-22 Remvoed backup folders
    [anna_elsa_displaydriver.kicad_sch, anna_elsa_displaydriver.sch, anna_elsa_esp32_cpu-B_Cu.dxf, anna_elsa_esp32_cpu-Edge_Cuts.dxf, anna_elsa_esp32_cpu-F_Cu.dxf, anna_elsa_esp32_cpu-F_Mask.dxf, anna_elsa_esp32_cpu-F_Paste.dxf, anna_elsa_esp32_cpu-F_Silkscreen.dxf]
2023-09-29 Latest schematics
    [anna_elsa_credit_display.kicad_pcb, anna_elsa_esp32_cpu.kicad_pcb, anna_elsa_esp32_cpu.kicad_sch, anna_elsa_moves_display.kicad_pcb, anna_elsa_reel_pcb.sch, audio.kicad_sch, cctalk.kicad_sch, esp32wroom.kicad_sch]
