chris83527/anna_elsa_schematics/(notices)

Notices in the files:
anna_elsa_esp32_cpu/anna_elsa_esp32_cpu.kicad_pcb:
©2022 Chris Woods
anna_elsa_credit_display/anna_elsa_credit_display.kicad_pcb:
(C)2021 Chris Woods
message_display_interface/message_display_interface.kicad_pcb:
(c)2021 Woods Amusements
